wZuck/Unextended/design/interconnect-map.csv

J2_pin | Signal
1 | GND
2 | GND
3 | VCC
4 | GND
5 | ROW_DRV0
6 | ROW_DRV1
7 | ROW_DRV2
8 | ROW_DRV3
9 | ROW_DRV4
10 | GND
11 | MUX_A
12 | MUX_B
13 | MUX_C
14 | MUX0_INH
15 | MUX1_INH
16 | GND
17 | DRAIN
18 | AFE_ON_N
19 | GND
20 | ADC
21 | GND
22 | BAT_SW
23 | RESET
24 | GND
