wZuck/Unextended/design/key-map.csv

ref | row | col | u | width | label | x | y
EC1 | 0 | 0 | 0 | 1 | Esc | 9.15 | 9.2
EC2 | 0 | 1 | 1 | 1 | 1 | 28.200000000000003 | 9.2
EC3 | 0 | 2 | 2 | 1 | 2 | 47.25 | 9.2
EC4 | 0 | 3 | 3 | 1 | 3 | 66.30000000000001 | 9.2
EC5 | 0 | 4 | 4 | 1 | 4 | 85.35000000000001 | 9.2
EC6 | 0 | 5 | 5 | 1 | 5 | 104.4 | 9.2
EC7 | 0 | 6 | 6 | 1 | 6 | 123.45000000000002 | 9.2
EC8 | 0 | 7 | 7 | 1 | 7 | 142.5 | 9.2
EC9 | 0 | 8 | 8 | 1 | 8 | 161.55 | 9.2
EC10 | 0 | 9 | 9 | 1 | 9 | 180.60000000000002 | 9.2
EC11 | 0 | 10 | 10 | 1 | 0 | 199.65 | 9.2
EC12 | 0 | 11 | 11 | 1 | - | 218.70000000000002 | 9.2
EC13 | 0 | 12 | 12 | 1 | = | 237.75000000000003 | 9.2
EC14 | 0 | 14 | 13 | 2 | Backspace | 266.325 | 9.2
EC15 | 1 | 0 | 0 | 1.5 | Tab | 13.912500000000001 | 28.25
EC16 | 1 | 2 | 1.5 | 1 | Q | 37.725 | 28.25
EC17 | 1 | 3 | 2.5 | 1 | W | 56.775 | 28.25
EC18 | 1 | 4 | 3.5 | 1 | E | 75.825 | 28.25
EC19 | 1 | 5 | 4.5 | 1 | R | 94.87500000000001 | 28.25
EC20 | 1 | 6 | 5.5 | 1 | T | 113.92500000000001 | 28.25
EC21 | 1 | 7 | 6.5 | 1 | Y | 132.975 | 28.25
EC22 | 1 | 8 | 7.5 | 1 | U | 152.025 | 28.25
EC23 | 1 | 9 | 8.5 | 1 | I | 171.07500000000002 | 28.25
EC24 | 1 | 10 | 9.5 | 1 | O | 190.125 | 28.25
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
