wZuck/Unextended/design/pin-map.csv

Signal | Pro_Micro_D | nRF52840_pin | Controller_U1_pad | J2_FFC_pin
ROW_DRV0 | 0 | P0.08 | 2 | 5
ROW_DRV1 | 1 | P0.06 | 1 | 6
ROW_DRV2 | 2 | P0.17 | 5 | 7
ROW_DRV3 | 3 | P0.20 | 6 | 8
ROW_DRV4 | 4 | P0.22 | 7 | 9
MUX_A | 5 | P0.24 | 8 | 11
MUX_B | 6 | P1.00 | 9 | 12
MUX_C | 7 | P0.11 | 10 | 13
MUX0_INH | 8 | P1.04 | 11 | 14
MUX1_INH | 9 | P1.06 | 12 | 15
DRAIN | 10 | P0.09 | 13 | 17
AFE_ON_N | 15 | P1.13 | 16 | 18
ADC | 19 | P0.02/AIN0 | 18 | 20
