wZuck/Unextended/renders/website-A2.png

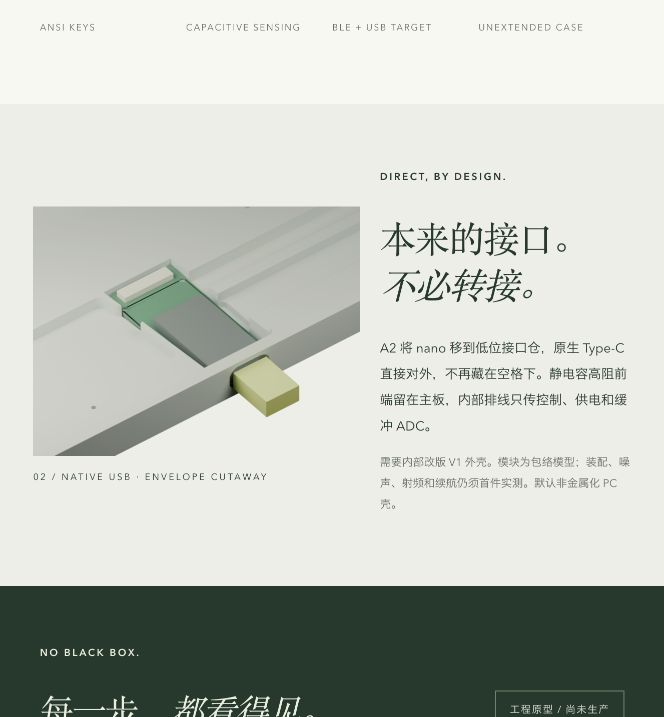
renders/website-A2.png
