wZuck/Unextended/renders/website-desktop.png

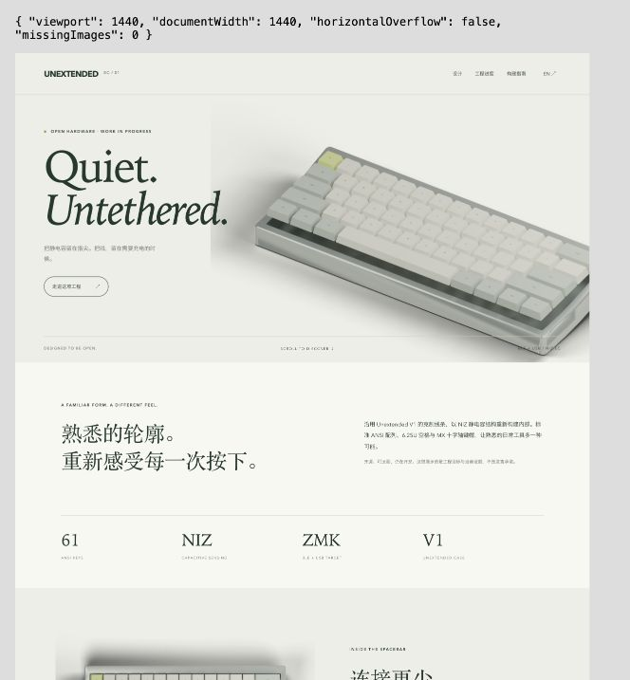
renders/website-desktop.png
