wZuck/Unextended/renders/website-mobile.png

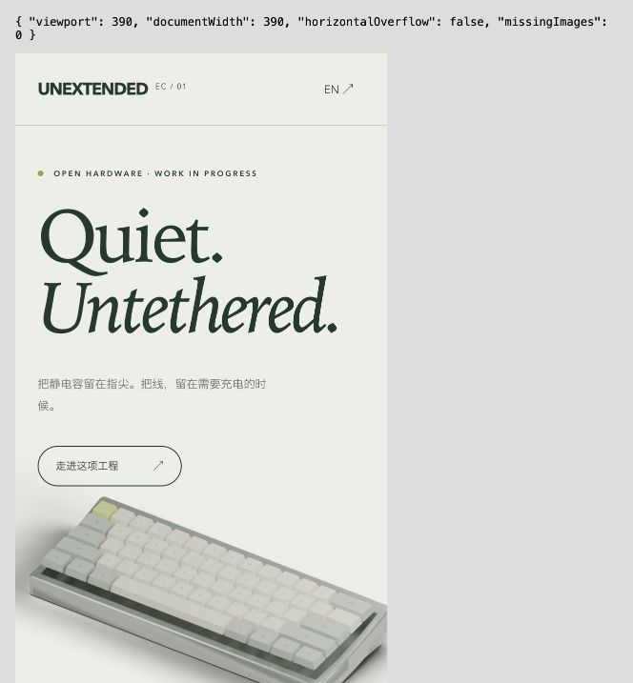
renders/website-mobile.png
