wZuck/Unextended/hardware/BOM.csv

Reference | Value | Footprint | Side | X_mm | Y_mm
J2 | FH12-24S-0.5SH | Connector_FFC-FPC:Hirose_FH12-24S-0.5SH_1x24-1MP_P0.50mm_Horizontal | B | 142.5 | 18.7
U2 | CD74HC4051M96 | Package_SO:SOIC-16_3.9x9.9mm_P1.27mm | B | 158 | 84
U3 | CD74HC4051M96 | Package_SO:SOIC-16_3.9x9.9mm_P1.27mm | B | 170 | 84
U4 | OPA350UA | Package_SO:SOIC-8_3.9x4.9mm_P1.27mm | B | 183 | 84
Q1 | AO3401A | Package_TO_SOT_SMD:SOT-23 | B | 207 | 84
R1 | 100 | Resistor_SMD:R_0805_2012Metric_Pad1.20x1.40mm_HandSolder | B | 40 | 78
R2 | 100 | Resistor_SMD:R_0805_2012Metric_Pad1.20x1.40mm_HandSolder | B | 46 | 78
R3 | 100 | Resistor_SMD:R_0805_2012Metric_Pad1.20x1.40mm_HandSolder | B | 52 | 78
R4 | 100 | Resistor_SMD:R_0805_2012Metric_Pad1.20x1.40mm_HandSolder | B | 58 | 75.8
R5 | 100 | Resistor_SMD:R_0805_2012Metric_Pad1.20x1.40mm_HandSolder | B | 64 | 78
R10 | 100k | Resistor_SMD:R_0805_2012Metric_Pad1.20x1.40mm_HandSolder | B | 119 | 78
R11 | 100k | Resistor_SMD:R_0805_2012Metric_Pad1.20x1.40mm_HandSolder | B | 126 | 78
R12 | 100k | Resistor_SMD:R_0805_2012Metric_Pad1.20x1.40mm_HandSolder | B | 133 | 78
R13 | 100k | Resistor_SMD:R_0805_2012Metric_Pad1.20x1.40mm_HandSolder | B | 140 | 78
R14 | 100k | Resistor_SMD:R_0805_2012Metric_Pad1.20x1.40mm_HandSolder | B | 147 | 78
R15 | 100k | Resistor_SMD:R_0805_2012Metric_Pad1.20x1.40mm_HandSolder | B | 125 | 75.8
R16 | 100k | Resistor_SMD:R_0805_2012Metric_Pad1.20x1.40mm_HandSolder | B | 126 | 84
R17 | 100k | Resistor_SMD:R_0805_2012Metric_Pad1.20x1.40mm_HandSolder | B | 133 | 84
R18 | 100k | Resistor_SMD:R_0805_2012Metric_Pad1.20x1.40mm_HandSolder | B | 140 | 84
R19 | 100k | Resistor_SMD:R_0805_2012Metric_Pad1.20x1.40mm_HandSolder | B | 147 | 84
R20 | 100k | Resistor_SMD:R_0805_2012Metric_Pad1.20x1.40mm_HandSolder | B | 125 | 92
R21 | 100k | Resistor_SMD:R_0805_2012Metric_Pad1.20x1.40mm_HandSolder | B | 126 | 90
R22 | 100k | Resistor_SMD:R_0805_2012Metric_Pad1.20x1.40mm_HandSolder | B | 133 | 90
R23 | 100k | Resistor_SMD:R_0805_2012Metric_Pad1.20x1.40mm_HandSolder | B | 140 | 90
R24 | 100k | Resistor_SMD:R_0805_2012Metric_Pad1.20x1.40mm_HandSolder | B | 147 | 90
R30 | 100k | Resistor_SMD:R_0805_2012Metric_Pad1.20x1.40mm_HandSolder | B | 183 | 78
R31 | 1k | Resistor_SMD:R_0805_2012Metric_Pad1.20x1.40mm_HandSolder | B | 183 | 91
R32 | 1k | Resistor_SMD:R_0805_2012Metric_Pad1.20x1.40mm_HandSolder | B | 232 | 78
R33 | 100k | Resistor_SMD:R_0805_2012Metric_Pad1.20x1.40mm_HandSolder | B | 156 | 75.5
R34 | 100k | Resistor_SMD:R_0805_2012Metric_Pad1.20x1.40mm_HandSolder | B | 164 | 78
R35 | 100k | Resistor_SMD:R_0805_2012Metric_Pad1.20x1.40mm_HandSolder | B | 200 | 78
R36 | 1k | Resistor_SMD:R_0805_2012Metric_Pad1.20x1.40mm_HandSolder | B | 207 | 78
R37 | 47 | Resistor_SMD:R_0805_2012Metric_Pad1.20x1.40mm_HandSolder | B | 187 | 78
C1 | 100n | Capacitor_SMD:C_0805_2012Metric_Pad1.18x1.45mm_HandSolder | B | 160 | 74.5
C2 | 100n | Capacitor_SMD:C_0805_2012Metric_Pad1.18x1.45mm_HandSolder | B | 164 | 91
C3 | 100n | Capacitor_SMD:C_0805_2012Metric_Pad1.18x1.45mm_HandSolder | B | 190 | 91
C4 | 220p_C0G | Capacitor_SMD:C_0805_2012Metric_Pad1.18x1.45mm_HandSolder | B | 178 | 72.5
C5 | 1u | Capacitor_SMD:C_0805_2012Metric_Pad1.18x1.45mm_HandSolder | B | 193 | 78
J1 | JST_S2B-PH-K | UnextendedEC:Battery_PH2 | B | 217 | 84
SW1 | Battery_switch_pigtail | UnextendedEC:SPST_PIGTAIL_2.54 | B | 178 | 91
SW2 | Reset_NO | UnextendedEC:RESET_2.54_TH | B | 238 | 91
EC1 | Esc | UnextendedEC:ecs_pad_1U_no_ring | F | 9.15 | 9.2
EC2 | 1 | UnextendedEC:ecs_pad_1U_no_ring | F | 28.200000000000003 | 9.2
EC3 | 2 | UnextendedEC:ecs_pad_1U_no_ring | F | 47.25 | 9.2
EC4 | 3 | UnextendedEC:ecs_pad_1U_no_ring | F | 66.30000000000001 | 9.2
EC5 | 4 | UnextendedEC:ecs_pad_1U_no_ring | F | 85.35000000000001 | 9.2
EC6 | 5 | UnextendedEC:ecs_pad_1U_no_ring | F | 104.4 | 9.2
EC7 | 6 | UnextendedEC:ecs_pad_1U_no_ring | F | 123.45000000000002 | 9.2
EC8 | 7 | UnextendedEC:ecs_pad_1U_no_ring | F | 142.5 | 9.2
EC9 | 8 | UnextendedEC:ecs_pad_1U_no_ring | F | 161.55 | 9.2
EC10 | 9 | UnextendedEC:ecs_pad_1U_no_ring | F | 180.60000000000002 | 9.2
EC11 | 0 | UnextendedEC:ecs_pad_1U_no_ring | F | 199.65 | 9.2
EC12 | - | UnextendedEC:ecs_pad_1U_no_ring | F | 218.70000000000002 | 9.2
EC13 | = | UnextendedEC:ecs_pad_1U_no_ring | F | 237.75000000000003 | 9.2
EC14 | Backspace | UnextendedEC:ecs_pad_1U_no_ring | F | 266.325 | 9.2
EC15 | Tab | UnextendedEC:ecs_pad_1U_no_ring | F | 13.912500000000001 | 28.25
EC16 | Q | UnextendedEC:ecs_pad_1U_no_ring | F | 37.725 | 28.25
EC17 | W | UnextendedEC:ecs_pad_1U_no_ring | F | 56.775 | 28.25
EC18 | E | UnextendedEC:ecs_pad_1U_no_ring | F | 75.825 | 28.25
EC19 | R | UnextendedEC:ecs_pad_1U_no_ring | F | 94.87500000000001 | 28.25
EC20 | T | UnextendedEC:ecs_pad_1U_no_ring | F | 113.92500000000001 | 28.25
EC21 | Y | UnextendedEC:ecs_pad_1U_no_ring | F | 132.975 | 28.25
EC22 | U | UnextendedEC:ecs_pad_1U_no_ring | F | 152.025 | 28.25
EC23 | I | UnextendedEC:ecs_pad_1U_no_ring | F | 171.07500000000002 | 28.25
EC24 | O | UnextendedEC:ecs_pad_1U_no_ring | F | 190.125 | 28.25
EC25 | P | UnextendedEC:ecs_pad_1U_no_ring | F | 209.175 | 28.25
EC26 | [ | UnextendedEC:ecs_pad_1U_no_ring | F | 228.22500000000002 | 28.25
EC27 | ] | UnextendedEC:ecs_pad_1U_no_ring | F | 247.275 | 28.25
EC28 | \ | UnextendedEC:ecs_pad_1U_no_ring | F | 271.0875 | 28.25
EC29 | Caps | UnextendedEC:ecs_pad_1U_no_ring | F | 16.293750000000003 | 47.3
EC30 | A | UnextendedEC:ecs_pad_1U_no_ring | F | 42.4875 | 47.3
EC31 | S | UnextendedEC:ecs_pad_1U_no_ring | F | 61.5375 | 47.3
EC32 | D | UnextendedEC:ecs_pad_1U_no_ring | F | 80.5875 | 47.3
EC33 | F | UnextendedEC:ecs_pad_1U_no_ring | F | 99.6375 | 47.3
EC34 | G | UnextendedEC:ecs_pad_1U_no_ring | F | 118.68750000000001 | 47.3
EC35 | H | UnextendedEC:ecs_pad_1U_no_ring | F | 137.7375 | 47.3
EC36 | J | UnextendedEC:ecs_pad_1U_no_ring | F | 156.78750000000002 | 47.3
EC37 | K | UnextendedEC:ecs_pad_1U_no_ring | F | 175.8375 | 47.3
EC38 | L | UnextendedEC:ecs_pad_1U_no_ring | F | 194.88750000000002 | 47.3
EC39 | ; | UnextendedEC:ecs_pad_1U_no_ring | F | 213.9375 | 47.3
EC40 | ' | UnextendedEC:ecs_pad_1U_no_ring | F | 232.9875 | 47.3
EC41 | Enter | UnextendedEC:ecs_pad_1U_no_ring | F | 263.94375 | 47.3
EC42 | Shift | UnextendedEC:ecs_pad_1U_no_ring | F | 21.05625 | 66.35000000000001
EC43 | Z | UnextendedEC:ecs_pad_1U_no_ring | F | 52.0125 | 66.35000000000001
EC44 | X | UnextendedEC:ecs_pad_1U_no_ring | F | 71.0625 | 66.35000000000001
EC45 | C | UnextendedEC:ecs_pad_1U_no_ring | F | 90.11250000000001 | 66.35000000000001
EC46 | V | UnextendedEC:ecs_pad_1U_no_ring | F | 109.16250000000001 | 66.35000000000001
EC47 | B | UnextendedEC:ecs_pad_1U_no_ring | F | 128.2125 | 66.35000000000001
EC48 | N | UnextendedEC:ecs_pad_1U_no_ring | F | 147.26250000000002 | 66.35000000000001
EC49 | M | UnextendedEC:ecs_pad_1U_no_ring | F | 166.3125 | 66.35000000000001
EC50 | , | UnextendedEC:ecs_pad_1U_no_ring | F | 185.3625 | 66.35000000000001
EC51 | . | UnextendedEC:ecs_pad_1U_no_ring | F | 204.41250000000002 | 66.35000000000001
EC52 | / | UnextendedEC:ecs_pad_1U_no_ring | F | 223.4625 | 66.35000000000001
EC53 | RShift | UnextendedEC:ecs_pad_1U_no_ring | F | 259.18125 | 66.35000000000001
EC54 | LCTRL | UnextendedEC:ecs_pad_1U_no_ring | F | 11.53125 | 85.4
EC55 | LGUI | UnextendedEC:ecs_pad_1U_no_ring | F | 35.34375 | 85.4
EC56 | LAlt | UnextendedEC:ecs_pad_1U_no_ring | F | 59.15625 | 85.4
EC57 | Space | UnextendedEC:ecs_pad_1U_no_ring | F | 130.59375 | 85.4
EC58 | RAlt | UnextendedEC:ecs_pad_1U_no_ring | F | 202.03125 | 85.4
EC59 | Fn | UnextendedEC:ecs_pad_1U_no_ring | F | 225.84375 | 85.4
EC60 | Menu | UnextendedEC:ecs_pad_1U_no_ring | F | 249.65625000000003 | 85.4
EC61 | RCTRL | UnextendedEC:ecs_pad_1U_no_ring | F | 273.46875 | 85.4
