wZuck/Unextended/mechanical/direct-usb-assembly.step

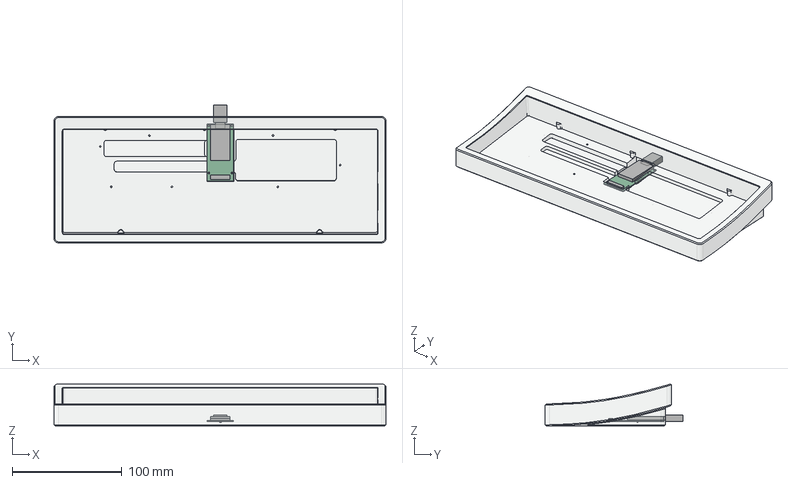
[picture p7: CAD file, 2026-10-23]
mechanical/direct-usb-assembly.step
302.3 x 125.4 x 38.1 mm
modified_PC_V1_case
carrier
module_envelope
ffc_connector
adc_capacitor
external_plug_envelope
