wZuck/Unextended/mechanical/reference/Unextended_V1_220331.step

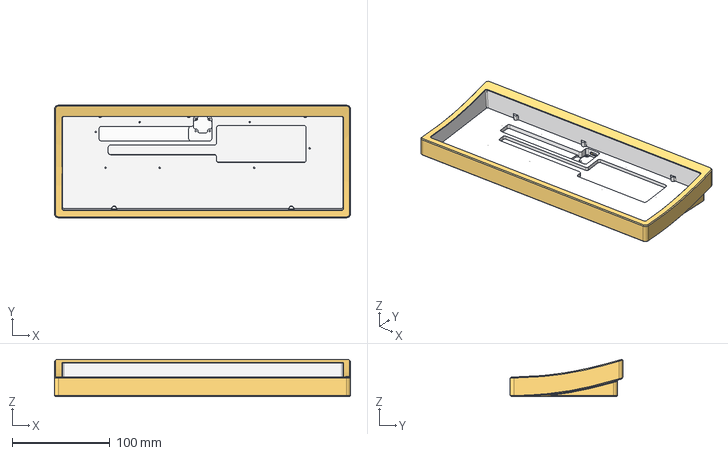
[picture p8: CAD file, 2026-10-23]
mechanical/reference/Unextended_V1_220331.step
302.3 x 115.0 x 38.1 mm
