wZuck/Unextended/mechanical/render/EC61.stl

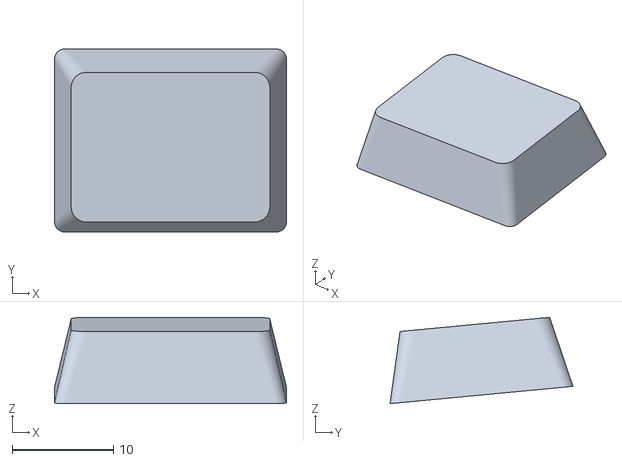
[picture p9: CAD file, 2026-10-23]
mechanical/render/EC61.stl
22.9 x 18.1 x 8.52
