wZuck/Unextended/mechanical/usb-render/external_plug_envelope.stl

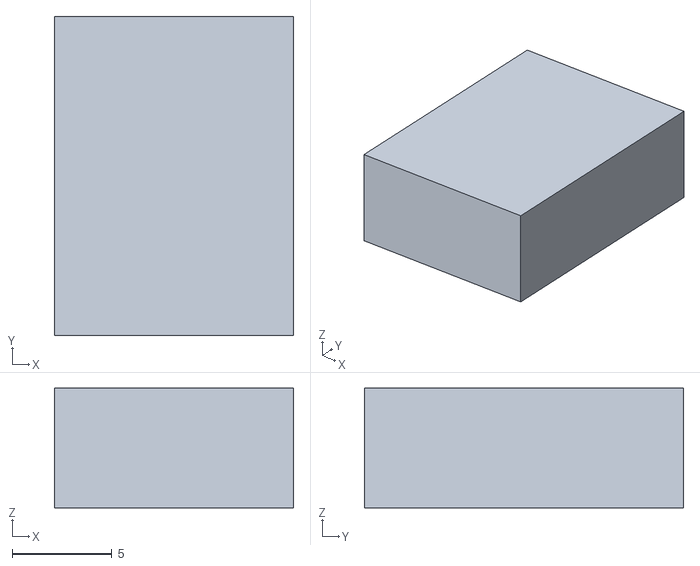
[picture p10: CAD file, 2026-10-23]
mechanical/usb-render/external_plug_envelope.stl
12.0 x 16.0 x 6.00
