wZuck/Unextended/mechanical/usb-render/adc_capacitor.stl

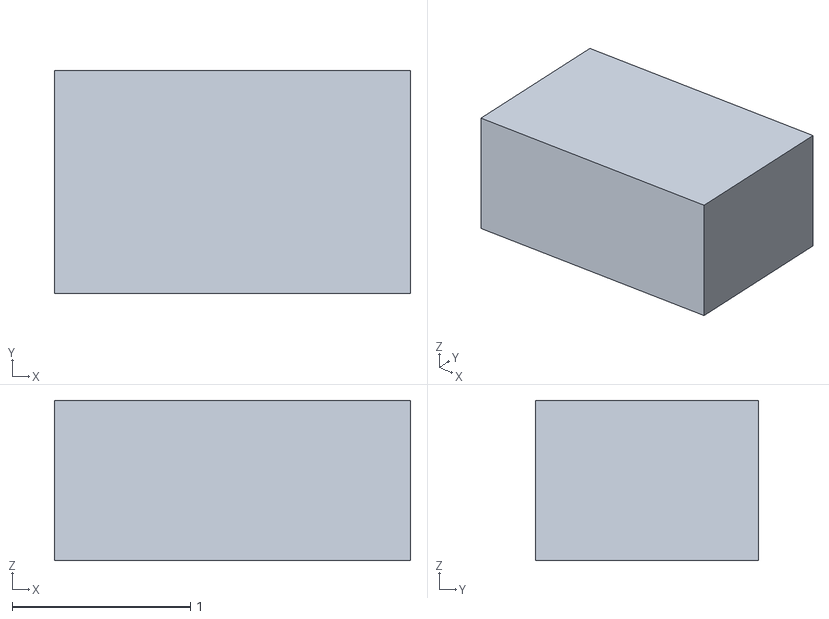
[picture p11: CAD file, 2026-10-23]
mechanical/usb-render/adc_capacitor.stl
2.00 x 1.25 x 0.9
