wZuck/Unextended/mechanical/render/EC49.stl

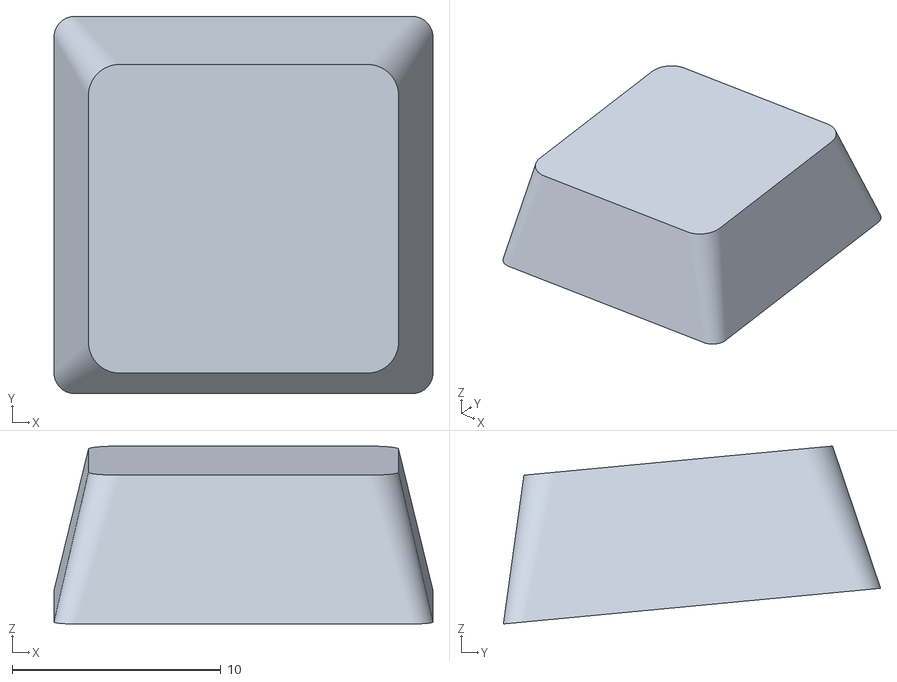
[picture p12: CAD file, 2026-10-23]
mechanical/render/EC49.stl
18.2 x 18.1 x 8.52
