wZuck/Unextended/mechanical/usb-carrier-envelope.step

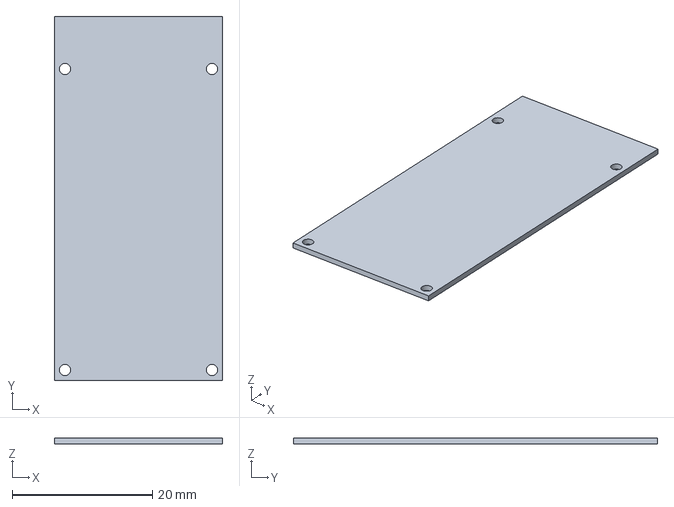
[picture p13: CAD file, 2026-10-23]
mechanical/usb-carrier-envelope.step
24.0 x 52.0 x 0.8 mm
