wZuck/Unextended/mechanical/usb-render/ffc_connector.stl

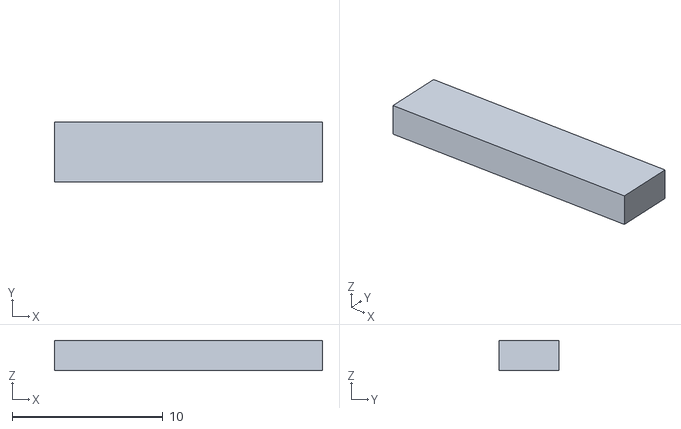
[picture p14: CAD file, 2026-10-23]
mechanical/usb-render/ffc_connector.stl
17.8 x 4.00 x 2.00
