wZuck/Unextended/mechanical/niz-fit-coupon.step

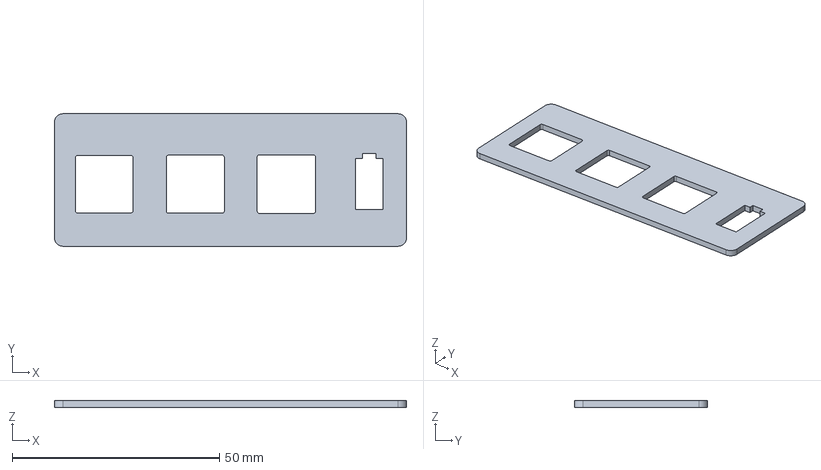
[picture p15: CAD file, 2026-10-23]
mechanical/niz-fit-coupon.step
85.0 x 32.0 x 1.60 mm
