wZuck/Unextended/mechanical/render/EC42.stl

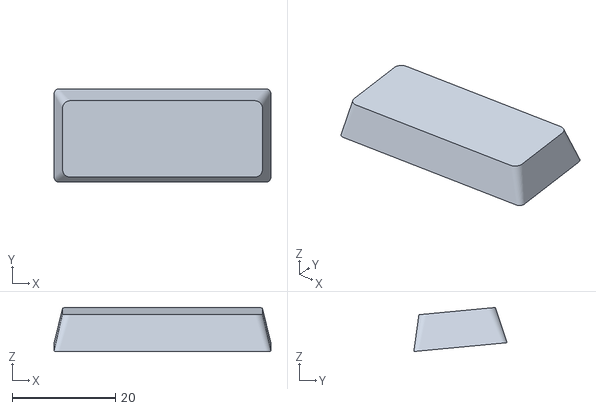
[picture p16: CAD file, 2026-10-23]
mechanical/render/EC42.stl
42.0 x 18.1 x 8.52
