wZuck/Unextended/mechanical/niz-ansi-plate.step

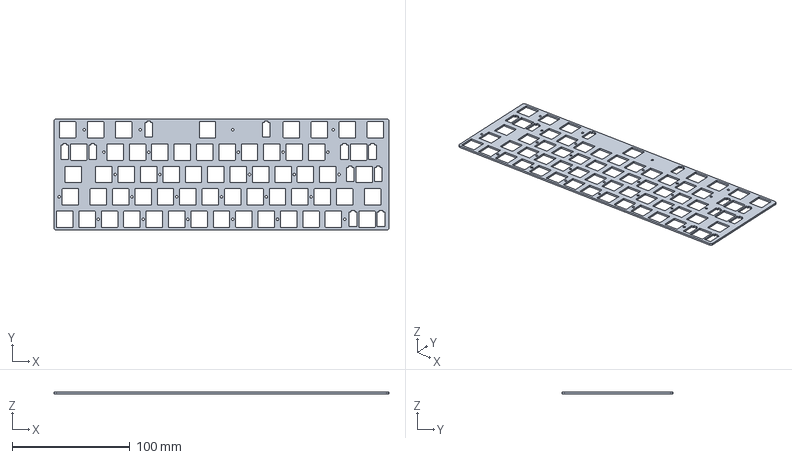
[picture p17: CAD file, 2026-10-23]
mechanical/niz-ansi-plate.step
285.0 x 94.6 x 1.60 mm
