wZuck/Unextended/mechanical/usb-render/case-cutaway.stl

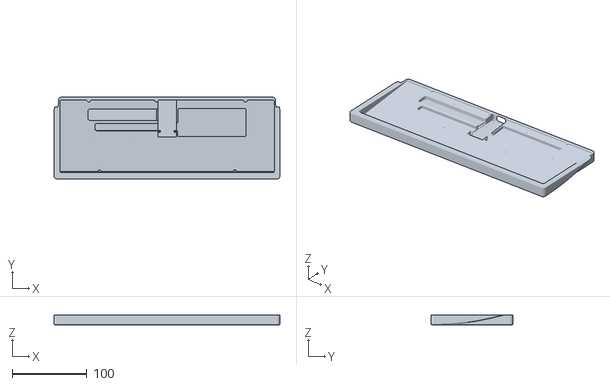
[picture p18: CAD file, 2026-10-23]
mechanical/usb-render/case-cutaway.stl
302.3 x 109.4 x 13.0
