wZuck/Unextended/mechanical/usb-render/module_envelope.stl

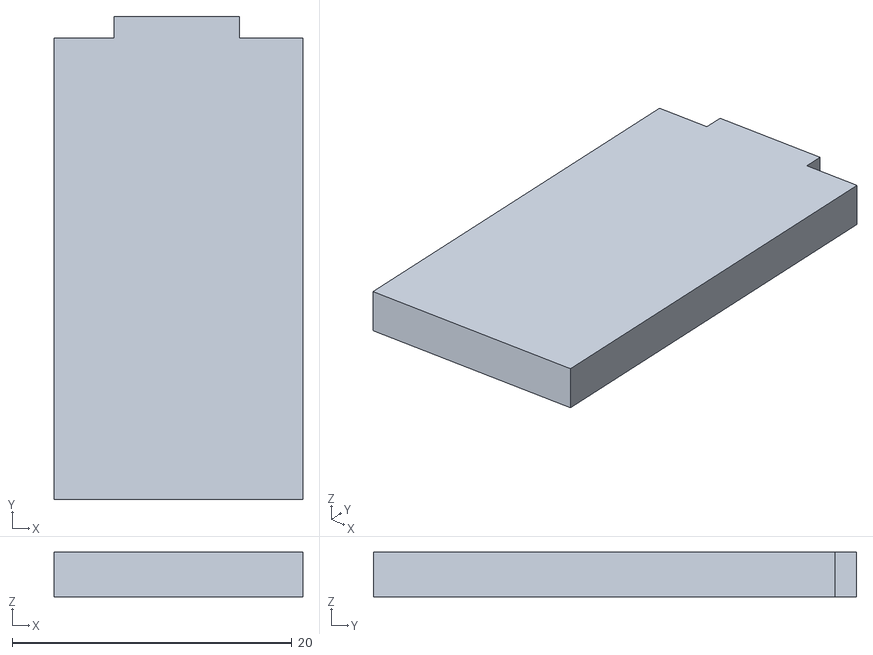
[picture p19: CAD file, 2026-10-23]
mechanical/usb-render/module_envelope.stl
17.8 x 34.5 x 3.20
