wZuck/Unextended/mechanical/render/EC28.stl

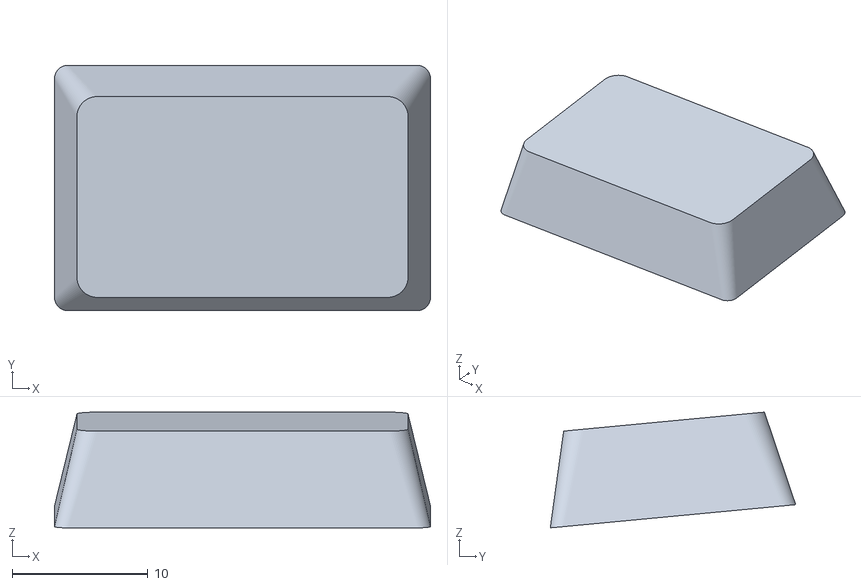
[picture p20: CAD file, 2026-10-23]
mechanical/render/EC28.stl
27.7 x 18.1 x 8.52
