wZuck/Unextended/mechanical/render/EC14.stl

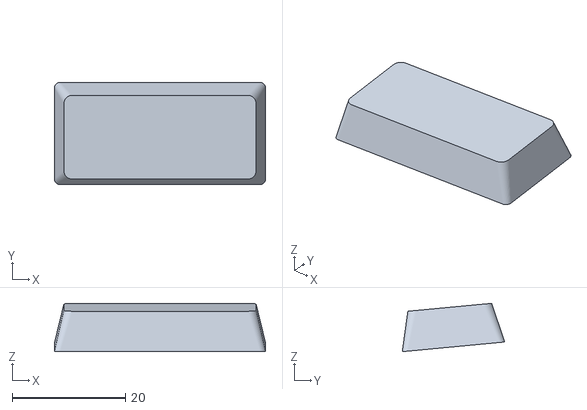
[picture p21: CAD file, 2026-10-23]
mechanical/render/EC14.stl
37.2 x 18.1 x 8.52
