wZuck/Unextended/mechanical/render/EC53.stl

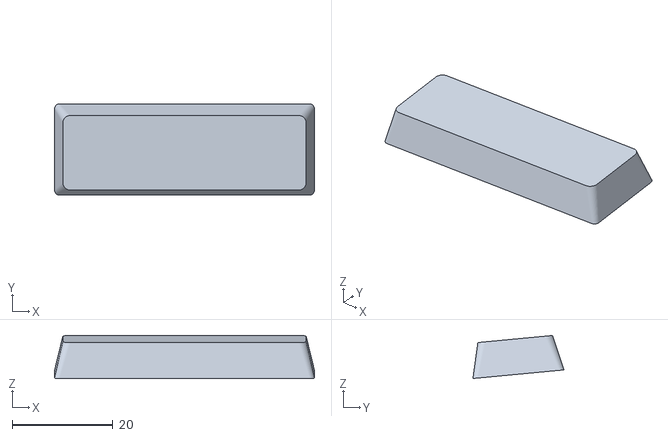
[picture p22: CAD file, 2026-10-23]
mechanical/render/EC53.stl
51.5 x 18.1 x 8.52
