wZuck/Unextended/mechanical/render/EC57.stl

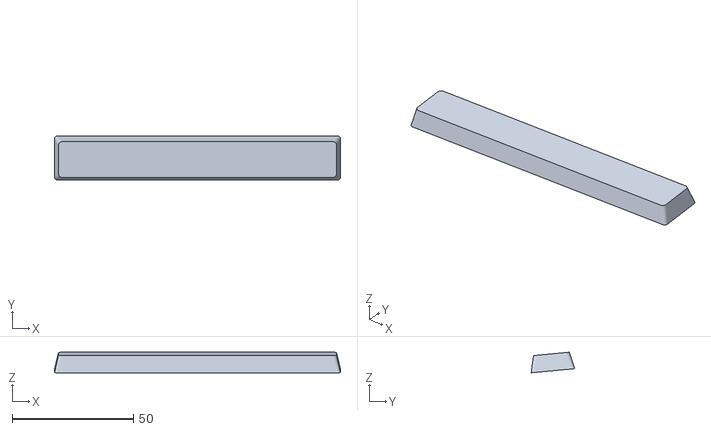
[picture p23: CAD file, 2026-10-23]
mechanical/render/EC57.stl
118.2 x 18.1 x 8.52
