wZuck/Unextended/mechanical/render/EC29.stl

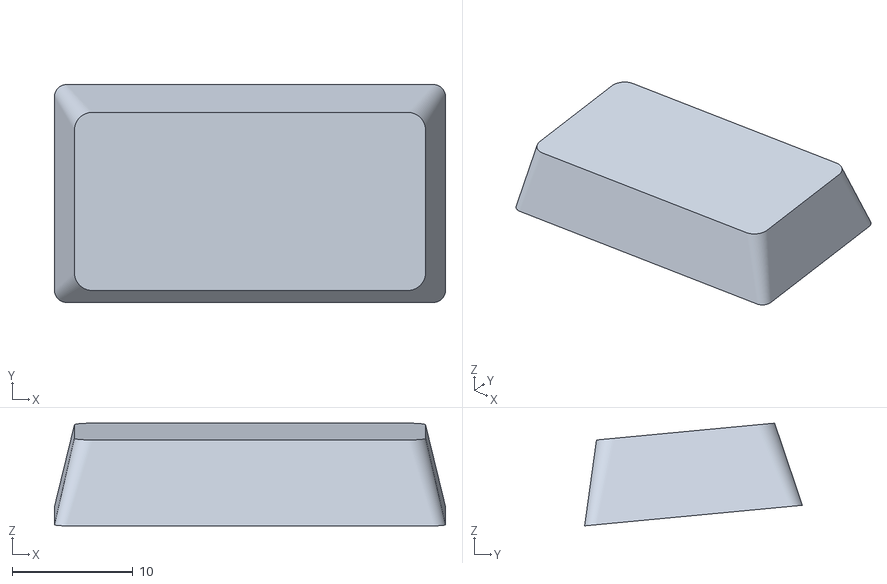
[picture p24: CAD file, 2026-10-23]
mechanical/render/EC29.stl
32.4 x 18.1 x 8.52
