wZuck/Unextended/(list of files, cad)

Other CAD files:
mechanical/Unextended_V1_EC_direct_USB.step
mechanical/render/EC54.stl
mechanical/usb-render/carrier.stl
mechanical/render/EC25.stl
mechanical/render/EC35.stl
mechanical/render/EC51.stl
mechanical/render/EC11.stl
mechanical/render/EC30.stl
mechanical/render/EC17.stl
mechanical/render/EC2.stl
mechanical/render/EC31.stl
mechanical/render/EC50.stl
mechanical/render/EC27.stl
mechanical/render/EC6.stl
mechanical/render/EC45.stl
mechanical/render/EC60.stl
mechanical/render/EC21.stl
mechanical/render/EC12.stl
mechanical/render/EC48.stl
mechanical/render/EC20.stl
mechanical/render/EC15.stl
mechanical/render/EC13.stl
mechanical/render/EC18.stl
mechanical/render/EC39.stl
mechanical/render/EC16.stl
mechanical/render/EC59.stl
mechanical/render/EC37.stl
mechanical/render/EC4.stl
mechanical/render/EC9.stl
mechanical/render/EC52.stl
mechanical/render/EC5.stl
mechanical/render/case.stl
mechanical/render/EC22.stl
mechanical/render/EC32.stl
mechanical/render/EC41.stl
mechanical/render/EC34.stl
mechanical/render/EC56.stl
mechanical/render/EC33.stl
mechanical/render/EC1.stl
mechanical/render/EC38.stl
mechanical/render/EC40.stl
mechanical/render/EC44.stl
mechanical/render/EC10.stl
mechanical/render/EC47.stl
mechanical/render/EC36.stl
mechanical/render/EC43.stl
mechanical/render/EC55.stl
mechanical/render/EC8.stl
mechanical/render/EC24.stl
mechanical/render/EC58.stl
mechanical/render/EC3.stl
mechanical/render/EC7.stl
mechanical/render/EC26.stl
mechanical/render/EC46.stl
mechanical/render/EC23.stl
mechanical/render/EC19.stl
mechanical/niz-ansi-plate.dxf
mechanical/niz-fit-coupon.dxf
renders/direct-usb-cutaway.blend
renders/unextended-concept.blend
