wZuck/Unextended/hardware/UnextendedEC-controller-schematic.pdf

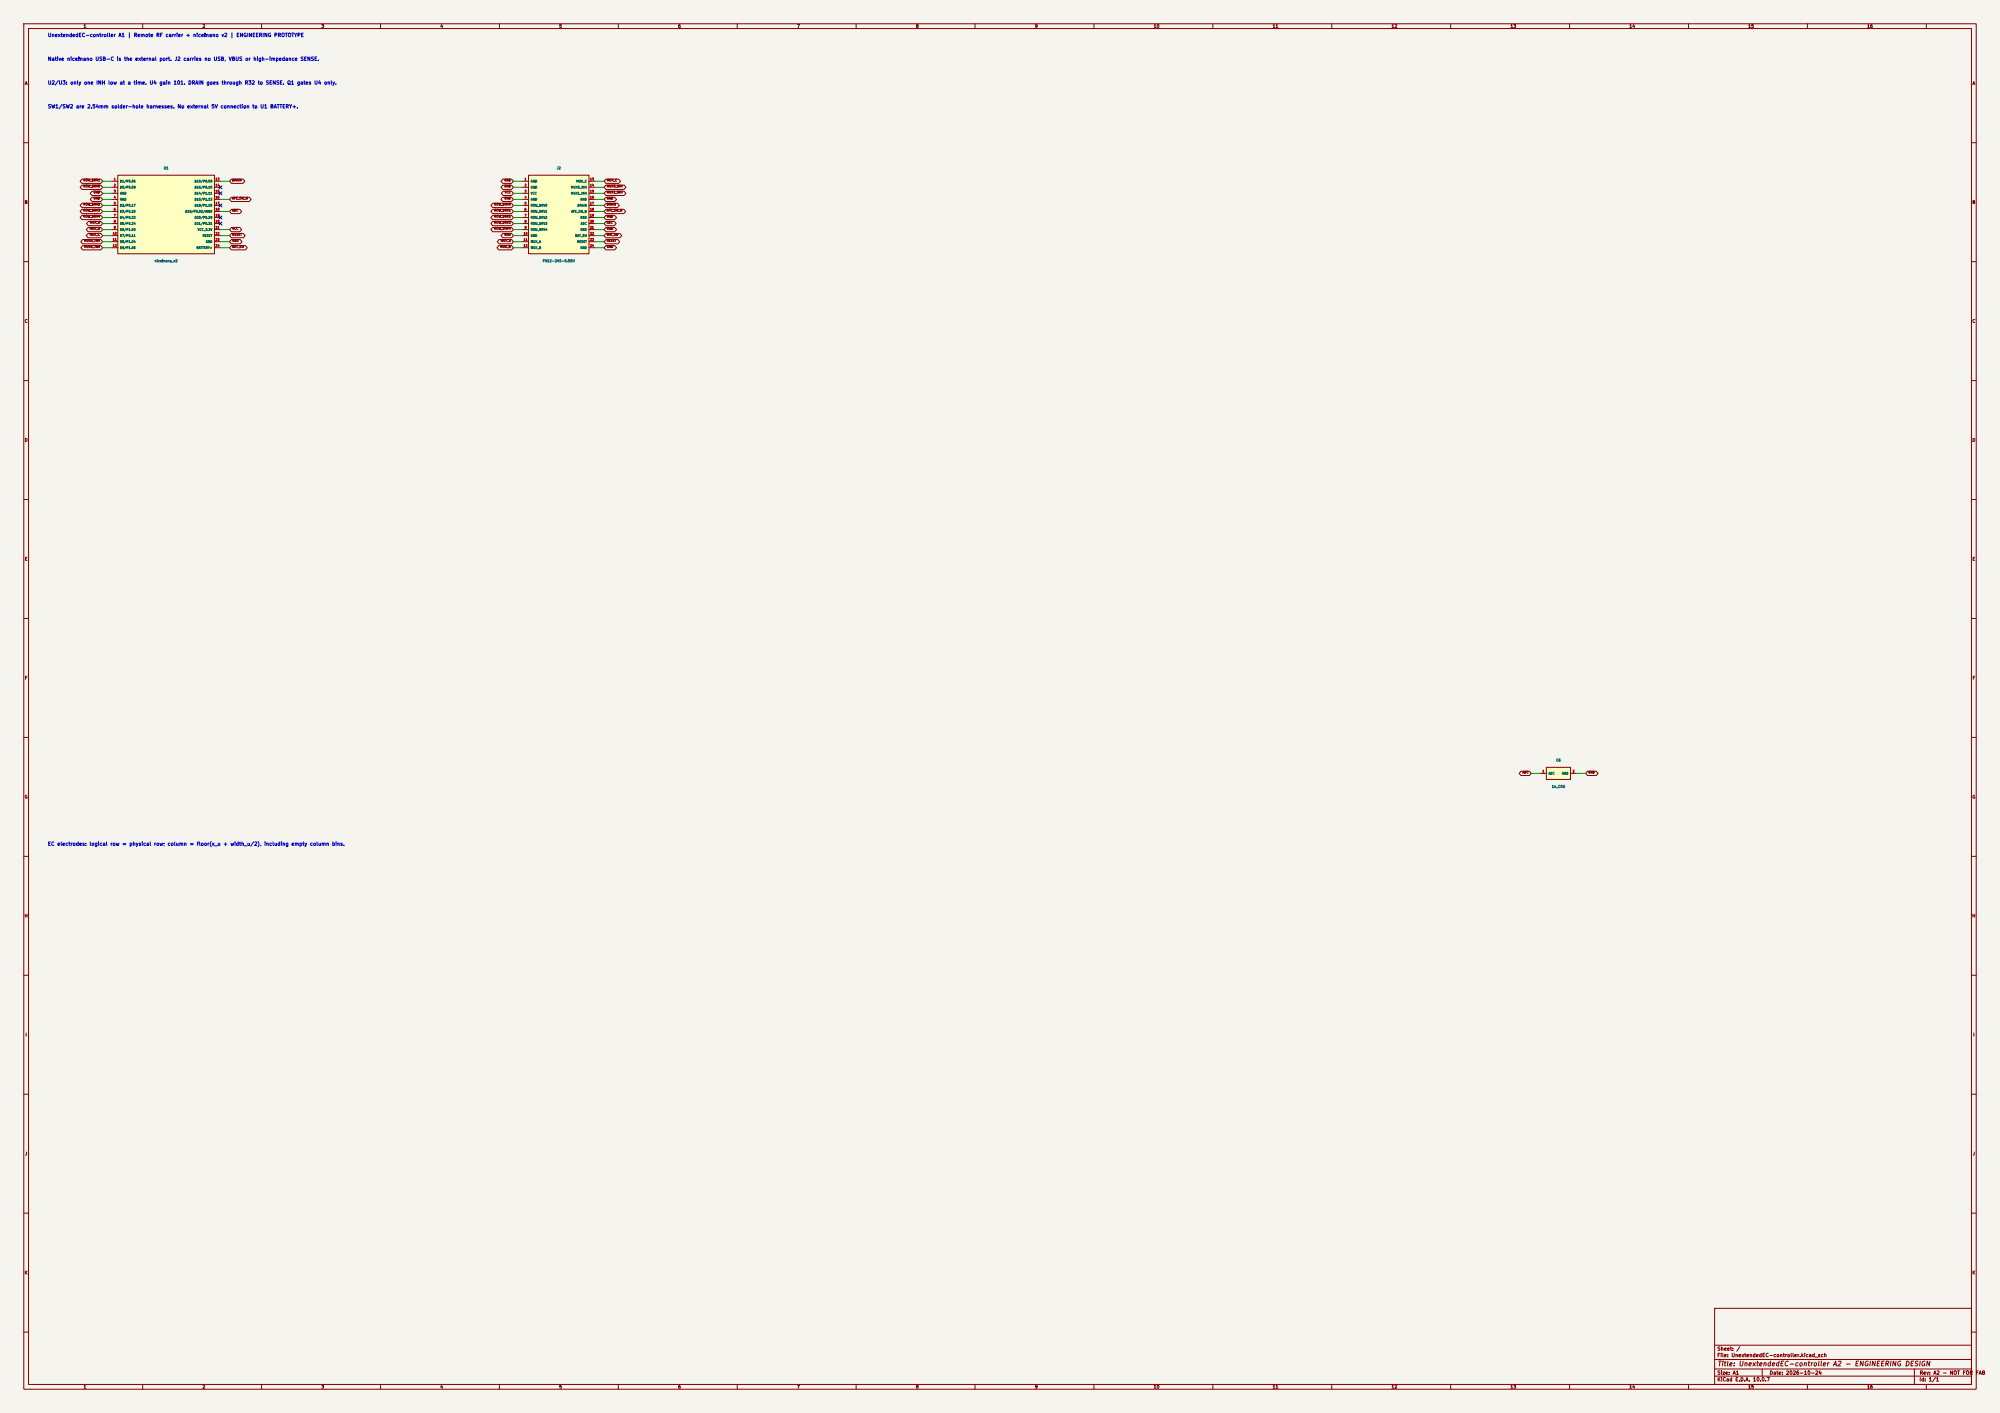
[picture p25: page 1]

ROW_DRV1 ROW_DRV0 UnextendedEC-controller A1 | Remote RF carrier + nice!nano v2 | ENGINEERING PROTOTYPE

Native nice!nano USB-C is the external port. J2 carries no USB, VBUS or high-impedance SENSE.

U2/U3: only one INH low at a time. U4 gain 101. DRAIN goes through R32 to SENSE. Q1 gates U4 only.

SW1/SW2 are 2.54mm solder-hole harnesses. No external 5V connection to U1 BATTERY+.

EC electrodes: logical row = physical row; column = floor(x_u + width_u/2), including empty column bins.

Sheet: /
File: UnextendedEC-controller.kicad_sch
Title: UnextendedEC-controller A2 - ENGINEERING DESIGN
