wZuck/Unextended/(list of files, drawings)

Other design files:
hardware/UnextendedEC-controller.dsn
hardware/UnextendedEC.dsn
