wZuck/Unextended/hardware/UnextendedEC.kicad_pcb

## KiCad design hardware/UnextendedEC.kicad_pcb (2026-10-23)

Schematic: UnextendedEC.kicad_sch, UnextendedEC A2 - ENGINEERING DESIGN

Parts:
C1, C2, C3: 100n; C_0805_2012Metric_Pad1.18x1.45mm_HandSolder
C4: 220p_C0G; C_0805_2012Metric_Pad1.18x1.45mm_HandSolder
C5: 1u; C_0805_2012Metric_Pad1.18x1.45mm_HandSolder
EC1: Esc; ecs_pad_1U_no_ring
EC2: 1; ecs_pad_1U_no_ring
EC3: 2; ecs_pad_1U_no_ring
EC4: 3; ecs_pad_1U_no_ring
EC5: 4; ecs_pad_1U_no_ring
EC6: 5; ecs_pad_1U_no_ring
EC7: 6; ecs_pad_1U_no_ring
EC8: 7; ecs_pad_1U_no_ring
EC9: 8; ecs_pad_1U_no_ring
EC10: 9; ecs_pad_1U_no_ring
EC11: 0; ecs_pad_1U_no_ring
EC12: -; ecs_pad_1U_no_ring
EC13: =; ecs_pad_1U_no_ring
EC14: Backspace; ecs_pad_1U_no_ring
EC15: Tab; ecs_pad_1U_no_ring
EC16: Q; ecs_pad_1U_no_ring
EC17: W; ecs_pad_1U_no_ring
EC18: E; ecs_pad_1U_no_ring
EC19: R; ecs_pad_1U_no_ring
EC20: T; ecs_pad_1U_no_ring
EC21: Y; ecs_pad_1U_no_ring
EC22: U; ecs_pad_1U_no_ring
EC23: I; ecs_pad_1U_no_ring
EC24: O; ecs_pad_1U_no_ring
EC25: P; ecs_pad_1U_no_ring
EC26: [; ecs_pad_1U_no_ring
EC27: ]; ecs_pad_1U_no_ring
EC28: \; ecs_pad_1U_no_ring
EC29: Caps; ecs_pad_1U_no_ring
EC30: A; ecs_pad_1U_no_ring
EC31: S; ecs_pad_1U_no_ring
EC32: D; ecs_pad_1U_no_ring
EC33: F; ecs_pad_1U_no_ring
EC34: G; ecs_pad_1U_no_ring
EC35: H; ecs_pad_1U_no_ring
EC36: J; ecs_pad_1U_no_ring
EC37: K; ecs_pad_1U_no_ring
EC38: L; ecs_pad_1U_no_ring
EC39: ;; ecs_pad_1U_no_ring
EC40: '; ecs_pad_1U_no_ring
EC41: Enter; ecs_pad_1U_no_ring
EC42: Shift; ecs_pad_1U_no_ring
EC43: Z; ecs_pad_1U_no_ring
EC44: X; ecs_pad_1U_no_ring
EC45: C; ecs_pad_1U_no_ring
EC46: V; ecs_pad_1U_no_ring
EC47: B; ecs_pad_1U_no_ring
EC48: N; ecs_pad_1U_no_ring
EC49: M; ecs_pad_1U_no_ring
EC50: ,; ecs_pad_1U_no_ring
EC51: .; ecs_pad_1U_no_ring
EC52: /; ecs_pad_1U_no_ring
EC53: RShift; ecs_pad_1U_no_ring
EC54: LCTRL; ecs_pad_1U_no_ring
EC55: LGUI; ecs_pad_1U_no_ring
EC56: LAlt; ecs_pad_1U_no_ring
EC57: Space; ecs_pad_1U_no_ring
EC58: RAlt; ecs_pad_1U_no_ring
EC59: Fn; ecs_pad_1U_no_ring
EC60: Menu; ecs_pad_1U_no_ring
EC61: RCTRL; ecs_pad_1U_no_ring
J1: JST_S2B-PH-K; Battery_PH2
J2: FH12-24S-0.5SH; Hirose_FH12-24S-0.5SH_1x24-1MP_P0.50mm_Horizontal
Q1: AO3401A; SOT-23
R1, R2, R3, R4, R5: 100; R_0805_2012Metric_Pad1.20x1.40mm_HandSolder
R10, R11, R12, R13, R14, R15, R16, R17, R18, R19, R20, R21, R22, R23, R24, R30, R33, R34, R35: 100k; R_0805_2012Metric_Pad1.20x1.40mm_HandSolder
R31, R32, R36: 1k; R_0805_2012Metric_Pad1.20x1.40mm_HandSolder
R37: 47; R_0805_2012Metric_Pad1.20x1.40mm_HandSolder
SW1: Battery_switch_pigtail; SPST_PIGTAIL_2.54
SW2: Reset_NO; RESET_2.54_TH
U2, U3: CD74HC4051M96; SOIC-16_3.9x9.9mm_P1.27mm
U4: OPA350UA; SOIC-8_3.9x4.9mm_P1.27mm

Connections:
ADC: J2.20 (ADC), R37.2 (ADC)
AFE_3V3: C3.1 (AFE_3V3), Q1.3 (D), U4.7 (V+)
AFE_GATE: Q1.1 (G), R35.1 (AFE_GATE), R36.2 (AFE_GATE)
AFE_ON_N: J2.18 (AFE_ON_N), R36.1 (AFE_ON_N)
AMP_OUT: R30.1 (AMP_OUT), R37.1 (AMP_OUT), U4.6 (OUT)
BAT_RAW: J1.1 (BAT_RAW), SW1.1 (BAT_RAW)
BAT_SW: J2.22 (BAT_SW), SW1.2 (BAT_SW)
COL0: EC1.2 (SENSE), EC15.2 (SENSE), EC29.2 (SENSE), EC54.2 (SENSE), R10.1 (COL0), U2.13 (X0)
COL1: EC2.2 (SENSE), EC42.2 (SENSE), EC55.2 (SENSE), R11.1 (COL1), U2.14 (X1)
COL2: EC3.2 (SENSE), EC16.2 (SENSE), EC30.2 (SENSE), EC43.2 (SENSE), R12.1 (COL2), U2.15 (X2)
COL3: EC4.2 (SENSE), EC17.2 (SENSE), EC31.2 (SENSE), EC44.2 (SENSE), EC56.2 (SENSE), R13.1 (COL3), U2.12 (X3)
COL4: EC5.2 (SENSE), EC18.2 (SENSE), EC32.2 (SENSE), EC45.2 (SENSE), R14.1 (COL4), U2.1 (X4)
COL5: EC6.2 (SENSE), EC19.2 (SENSE), EC33.2 (SENSE), EC46.2 (SENSE), R15.1 (COL5), U2.5 (X5)
COL6: EC7.2 (SENSE), EC20.2 (SENSE), EC34.2 (SENSE), EC47.2 (SENSE), EC57.2 (SENSE), R16.1 (COL6), U2.2 (X6)
COL7: EC8.2 (SENSE), EC21.2 (SENSE), EC35.2 (SENSE), EC48.2 (SENSE), R17.1 (COL7), U2.4 (X7)
COL8: EC9.2 (SENSE), EC22.2 (SENSE), EC36.2 (SENSE), EC49.2 (SENSE), R18.1 (COL8), U3.13 (X0)
COL9: EC10.2 (SENSE), EC23.2 (SENSE), EC37.2 (SENSE), EC50.2 (SENSE), R19.1 (COL9), U3.14 (X1)
COL10: EC11.2 (SENSE), EC24.2 (SENSE), EC38.2 (SENSE), EC51.2 (SENSE), EC58.2 (SENSE), R20.1 (COL10), U3.15 (X2)
COL11: EC12.2 (SENSE), EC25.2 (SENSE), EC39.2 (SENSE), EC52.2 (SENSE), EC59.2 (SENSE), R21.1 (COL11), U3.12 (X3)
COL12: EC13.2 (SENSE), EC26.2 (SENSE), EC40.2 (SENSE), R22.1 (COL12), U3.1 (X4)
COL13: EC27.2 (SENSE), EC41.2 (SENSE), EC53.2 (SENSE), EC60.2 (SENSE), R23.1 (COL13), U3.5 (X5)
COL14: EC14.2 (SENSE), EC28.2 (SENSE), EC61.2 (SENSE), R24.1 (COL14), U3.2 (X6)
DRAIN: J2.17 (DRAIN), R32.1 (DRAIN)
FB: R30.2 (FB), R31.1 (FB), U4.2 (IN-)
GND: C1.2 (GND), C2.2 (GND), C3.2 (GND), C4.2 (GND), C5.2 (GND), EC1.3 (GUARD), EC2.3 (GUARD), EC3.3 (GUARD), EC4.3 (GUARD), EC5.3 (GUARD), EC6.3 (GUARD), EC7.3 (GUARD), EC8.3 (GUARD), EC9.3 (GUARD), EC10.3 (GUARD), EC11.3 (GUARD), EC12.3 (GUARD), EC13.3 (GUARD), EC14.3 (GUARD), EC15.3 (GUARD), EC16.3 (GUARD), EC17.3 (GUARD), EC18.3 (GUARD), EC19.3 (GUARD), EC20.3 (GUARD), EC21.3 (GUARD), EC22.3 (GUARD), EC23.3 (GUARD), EC24.3 (GUARD), EC25.3 (GUARD), EC26.3 (GUARD), EC27.3 (GUARD), EC28.3 (GUARD), EC29.3 (GUARD), EC30.3 (GUARD), EC31.3 (GUARD), EC32.3 (GUARD), EC33.3 (GUARD), EC34.3 (GUARD), EC35.3 (GUARD), EC36.3 (GUARD), EC37.3 (GUARD), EC38.3 (GUARD), EC39.3 (GUARD), EC40.3 (GUARD), EC41.3 (GUARD), EC42.3 (GUARD), EC43.3 (GUARD), EC44.3 (GUARD), EC45.3 (GUARD), EC46.3 (GUARD), EC47.3 (GUARD), EC48.3 (GUARD), EC49.3 (GUARD), EC50.3 (GUARD), EC51.3 (GUARD), EC52.3 (GUARD), EC53.3 (GUARD), EC54.3 (GUARD), EC55.3 (GUARD), EC56.3 (GUARD), EC57.3 (GUARD), EC58.3 (GUARD), EC59.3 (GUARD), EC60.3 (GUARD), EC61.3 (GUARD), J1.2 (GND), J2.1 (GND), J2.2 (GND), J2.4 (GND), J2.10 (GND), J2.16 (GND), J2.19 (GND), J2.21 (GND), J2.24 (GND), R10.2 (GND), R11.2 (GND), R12.2 (GND), R13.2 (GND), R14.2 (GND), R15.2 (GND), R16.2 (GND), R17.2 (GND), R18.2 (GND), R19.2 (GND), R20.2 (GND), R21.2 (GND), R22.2 (GND), R23.2 (GND), R24.2 (GND), R31.2 (GND), SW2.2 (GND), U2.7 (VEE), U2.8 (GND), U3.4 (X7), U3.7 (VEE), U3.8 (GND), U4.4 (V-)
MUX0_INH: J2.14 (MUX0_INH), R33.1 (MUX0_INH), U2.6 (INH)
MUX1_INH: J2.15 (MUX1_INH), R34.1 (MUX1_INH), U3.6 (INH)
MUX_A: J2.11 (MUX_A), U2.11 (A), U3.11 (A)
MUX_B: J2.12 (MUX_B), U2.10 (B), U3.10 (B)
MUX_C: J2.13 (MUX_C), U2.9 (C), U3.9 (C)
RESET: J2.23 (RESET), SW2.1 (RESET)
ROW0: EC1.1 (DRIVE), EC2.1 (DRIVE), EC3.1 (DRIVE), EC4.1 (DRIVE), EC5.1 (DRIVE), EC6.1 (DRIVE), EC7.1 (DRIVE), EC8.1 (DRIVE), EC9.1 (DRIVE), EC10.1 (DRIVE), EC11.1 (DRIVE), EC12.1 (DRIVE), EC13.1 (DRIVE), EC14.1 (DRIVE), R1.2 (ROW0)
ROW1: EC15.1 (DRIVE), EC16.1 (DRIVE), EC17.1 (DRIVE), EC18.1 (DRIVE), EC19.1 (DRIVE), EC20.1 (DRIVE), EC21.1 (DRIVE), EC22.1 (DRIVE), EC23.1 (DRIVE), EC24.1 (DRIVE), EC25.1 (DRIVE), EC26.1 (DRIVE), EC27.1 (DRIVE), EC28.1 (DRIVE), R2.2 (ROW1)
ROW2: EC29.1 (DRIVE), EC30.1 (DRIVE), EC31.1 (DRIVE), EC32.1 (DRIVE), EC33.1 (DRIVE), EC34.1 (DRIVE), EC35.1 (DRIVE), EC36.1 (DRIVE), EC37.1 (DRIVE), EC38.1 (DRIVE), EC39.1 (DRIVE), EC40.1 (DRIVE), EC41.1 (DRIVE), R3.2 (ROW2)
ROW3: EC42.1 (DRIVE), EC43.1 (DRIVE), EC44.1 (DRIVE), EC45.1 (DRIVE), EC46.1 (DRIVE), EC47.1 (DRIVE), EC48.1 (DRIVE), EC49.1 (DRIVE), EC50.1 (DRIVE), EC51.1 (DRIVE), EC52.1 (DRIVE), EC53.1 (DRIVE), R4.2 (ROW3)
ROW4: EC54.1 (DRIVE), EC55.1 (DRIVE), EC56.1 (DRIVE), EC57.1 (DRIVE), EC58.1 (DRIVE), EC59.1 (DRIVE), EC60.1 (DRIVE), EC61.1 (DRIVE), R5.2 (ROW4)
ROW_DRV0: J2.5 (ROW_DRV0), R1.1 (ROW_DRV0)
ROW_DRV1: J2.6 (ROW_DRV1), R2.1 (ROW_DRV1)
ROW_DRV2: J2.7 (ROW_DRV2), R3.1 (ROW_DRV2)
ROW_DRV3: J2.8 (ROW_DRV3), R4.1 (ROW_DRV3)
ROW_DRV4: J2.9 (ROW_DRV4), R5.1 (ROW_DRV4)
SENSE: C4.1 (SENSE), R32.2 (SENSE), U2.3 (COM), U3.3 (COM), U4.3 (IN+)
VCC: C1.1 (VCC), C2.1 (VCC), C5.1 (VCC), J2.3 (VCC), Q1.2 (S), R33.2 (VCC), R34.2 (VCC), R35.2 (VCC), U2.16 (VCC), U3.16 (VCC)

Notes on the sheet:
UnextendedEC A2 | NiZ EC + ANSI 6.25u + nice!nano v2 | ENGINEERING PROTOTYPE
Native nice!nano USB-C is the external port. J2 carries no USB, VBUS or high-impedance SENSE.
U2/U3: only one INH low at a time. U4 gain 101. DRAIN goes through R32 to SENSE. Q1 gates U4 only.
SW1/SW2 are 2.54mm solder-hole harnesses. No external 5V connection to U1 BATTERY+.
EC electrodes: logical row = physical row; column = floor(x_u + width_u/2), including empty column bins.

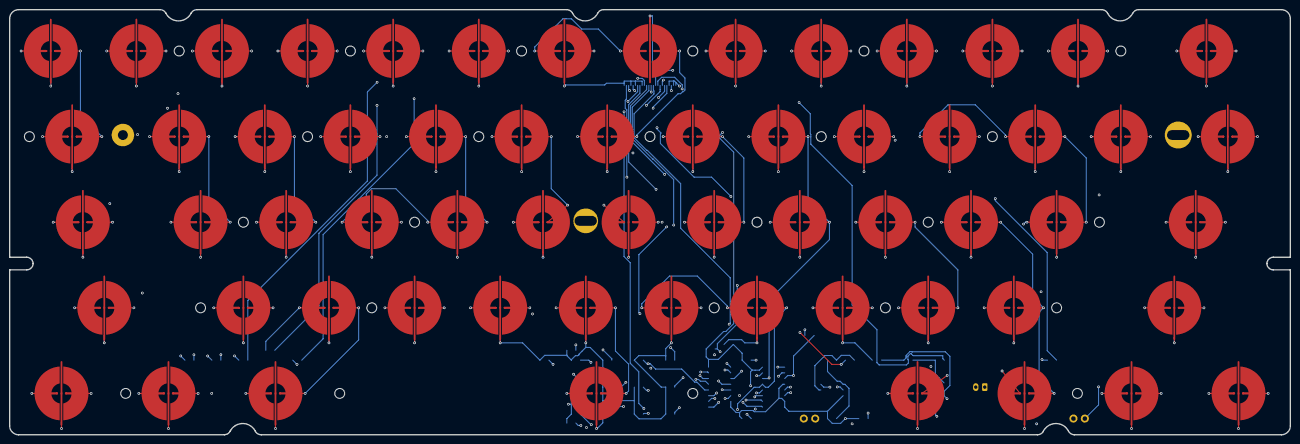
[picture p26: board UnextendedEC.kicad_pcb from above]

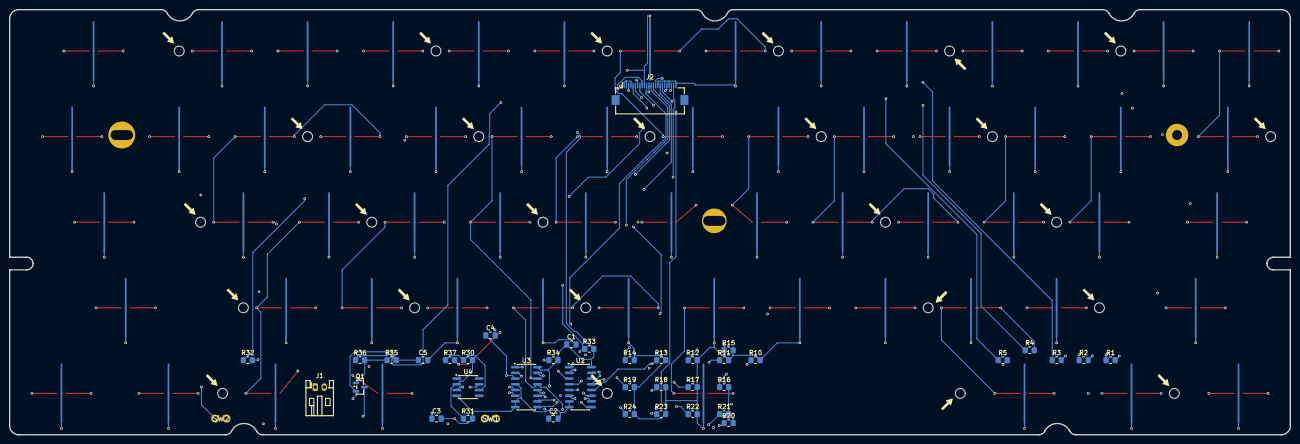
[picture p27: board UnextendedEC.kicad_pcb from below]

Board: 4 copper layers, 285.0 x 94.6 mm, 128 parts (41 on the bottom side), 43 nets.

Other parts of the board:
H1, H2, H3, H4, H5, H6, H7, H8, H9, H10, H11, H12, H13, H14, H15, H16, H17, H18, H19, H20, H21, H22, H23, H24, H25, H26: MountingHole; HOLE_M2
