wZuck/Unextended/hardware/UnextendedEC-controller.kicad_pcb

## KiCad design hardware/UnextendedEC-controller.kicad_pcb (2026-10-23)

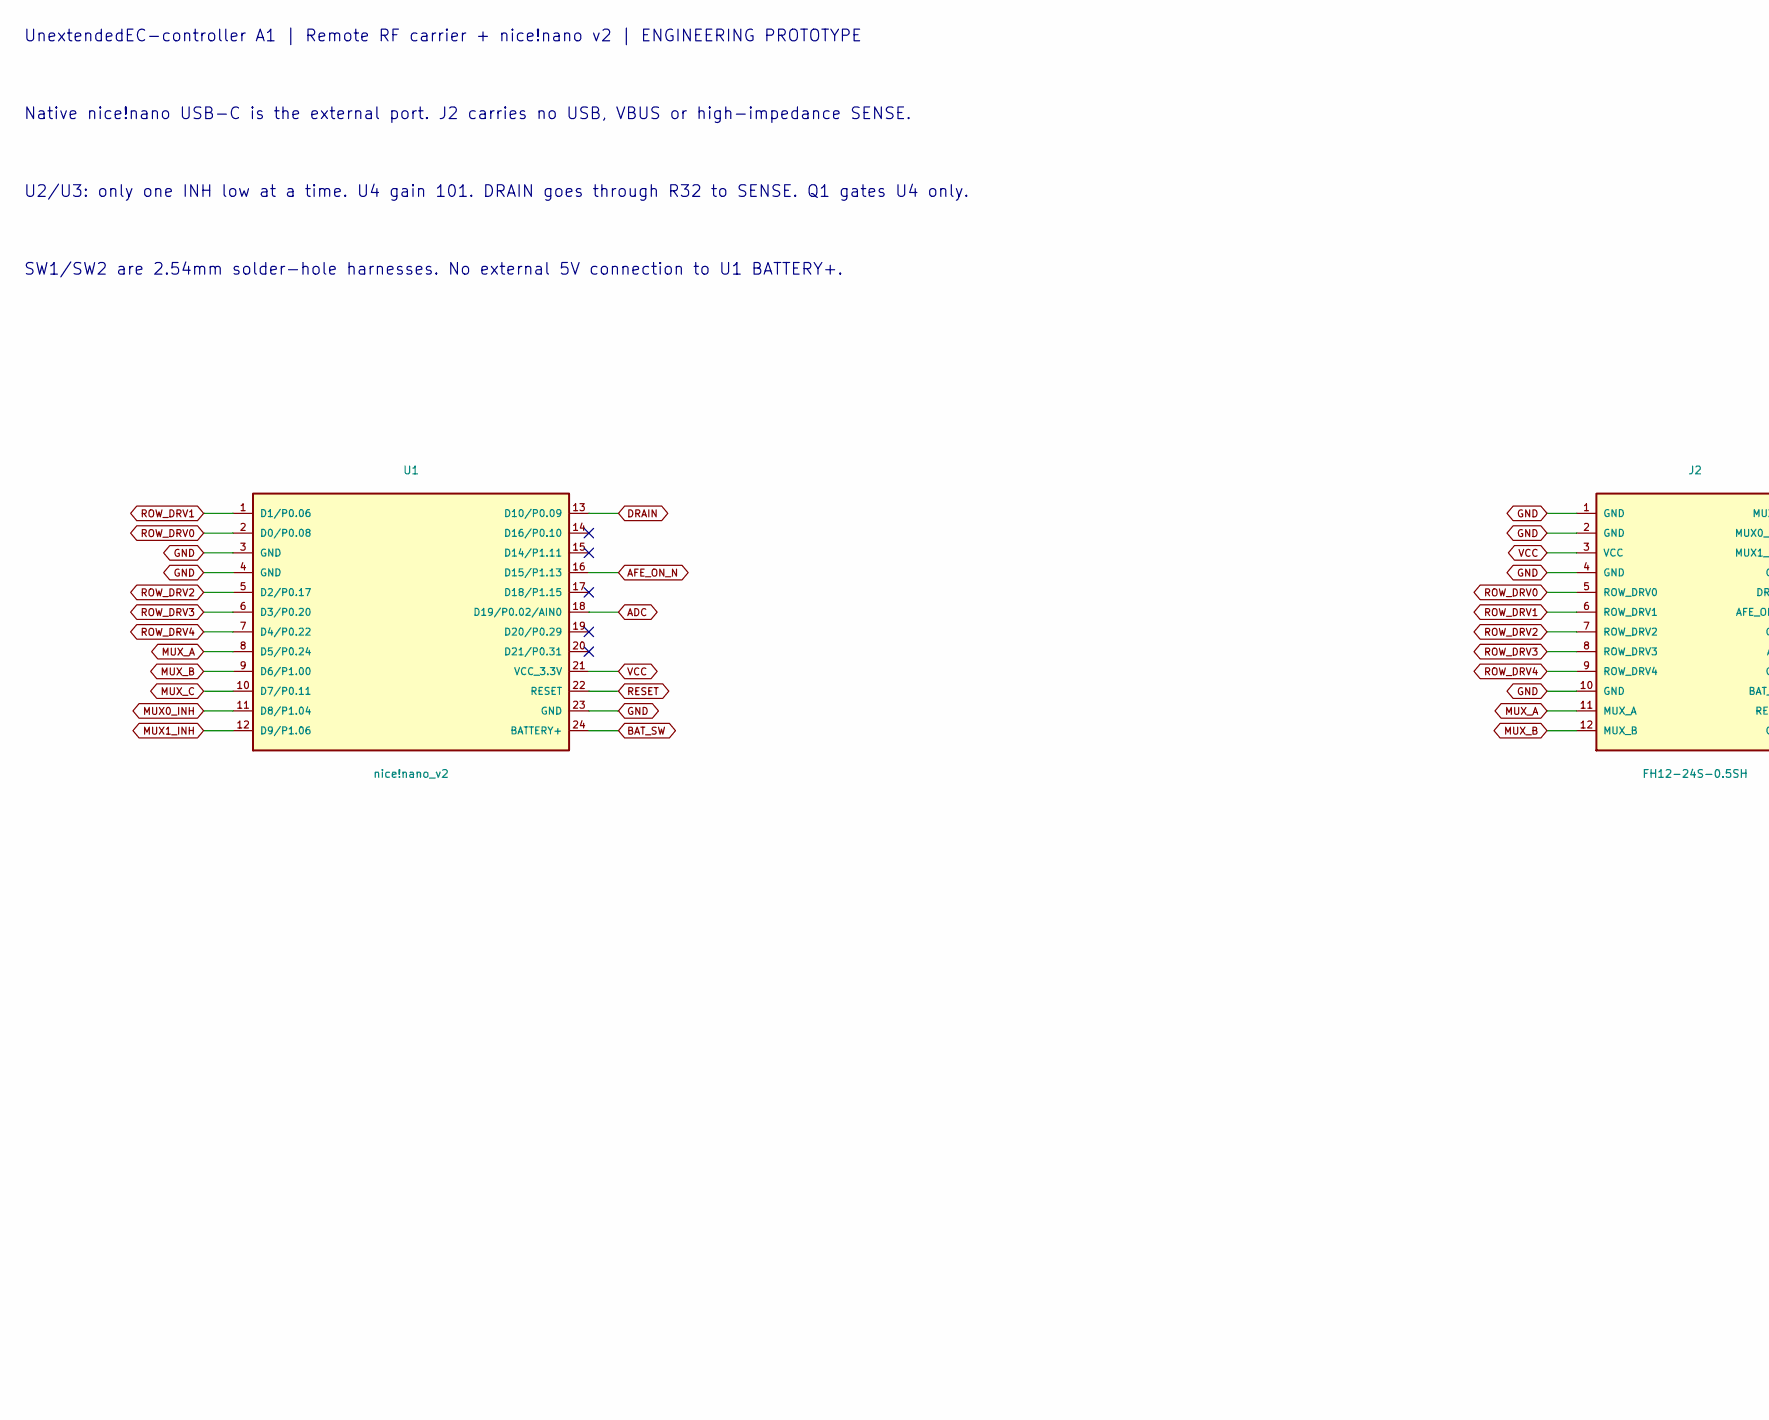
[picture p28: schematic UnextendedEC-controller.kicad_sch, UnextendedEC-controller A2 - ENGINEERING DESIGN, part in row 1, column 1]

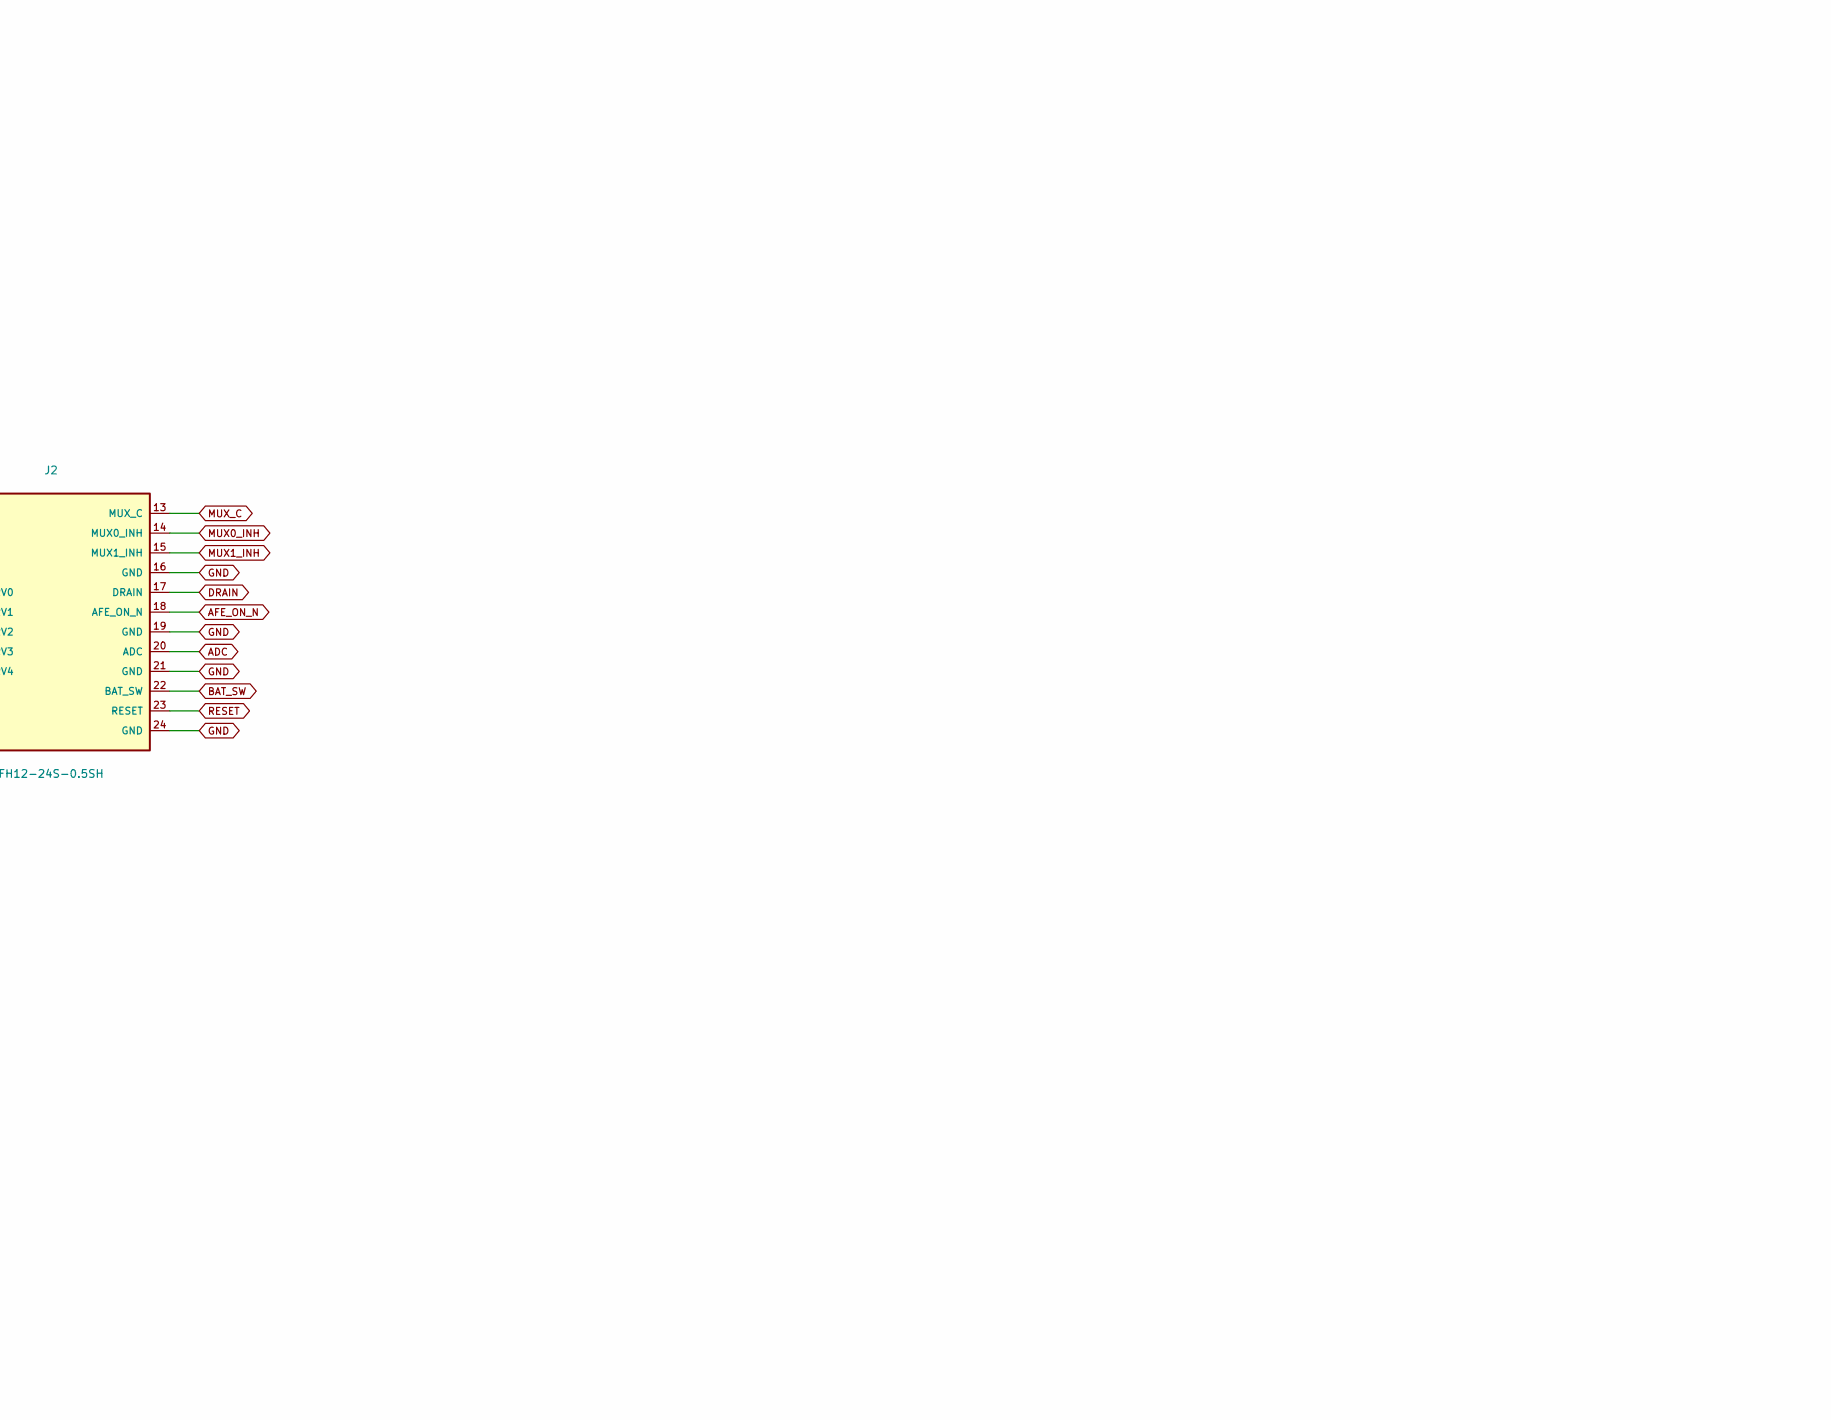
[picture p29: schematic UnextendedEC-controller.kicad_sch, UnextendedEC-controller A2 - ENGINEERING DESIGN, part in row 1, column 2]

Parts:
C6: 1n_C0G; C_0805_2012Metric_Pad1.18x1.45mm_HandSolder
J2: FH12-24S-0.5SH; Hirose_FH12-24S-0.5SH_1x24-1MP_P0.50mm_Horizontal
U1: nice!nano_v2; nice_nano

Connections:
ADC: C6.1 (ADC), J2.20 (ADC), U1.18 (D19/P0.02/AIN0)
AFE_ON_N: J2.18 (AFE_ON_N), U1.16 (D15/P1.13)
BAT_SW: J2.22 (BAT_SW), U1.24 (BATTERY+)
DRAIN: J2.17 (DRAIN), U1.13 (D10/P0.09)
GND: C6.2 (GND), J2.1 (GND), J2.2 (GND), J2.4 (GND), J2.10 (GND), J2.16 (GND), J2.19 (GND), J2.21 (GND), J2.24 (GND), U1.3 (GND), U1.4 (GND), U1.23 (GND)
MUX0_INH: J2.14 (MUX0_INH), U1.11 (D8/P1.04)
MUX1_INH: J2.15 (MUX1_INH), U1.12 (D9/P1.06)
MUX_A: J2.11 (MUX_A), U1.8 (D5/P0.24)
MUX_B: J2.12 (MUX_B), U1.9 (D6/P1.00)
MUX_C: J2.13 (MUX_C), U1.10 (D7/P0.11)
RESET: J2.23 (RESET), U1.22 (RESET)
ROW_DRV0: J2.5 (ROW_DRV0), U1.2 (D0/P0.08)
ROW_DRV1: J2.6 (ROW_DRV1), U1.1 (D1/P0.06)
ROW_DRV2: J2.7 (ROW_DRV2), U1.5 (D2/P0.17)
ROW_DRV3: J2.8 (ROW_DRV3), U1.6 (D3/P0.20)
ROW_DRV4: J2.9 (ROW_DRV4), U1.7 (D4/P0.22)
VCC: J2.3 (VCC), U1.21 (VCC_3.3V)

Notes on the sheet:
UnextendedEC-controller A1 | Remote RF carrier + nice!nano v2 | ENGINEERING PROTOTYPE
Native nice!nano USB-C is the external port. J2 carries no USB, VBUS or high-impedance SENSE.
U2/U3: only one INH low at a time. U4 gain 101. DRAIN goes through R32 to SENSE. Q1 gates U4 only.
SW1/SW2 are 2.54mm solder-hole harnesses. No external 5V connection to U1 BATTERY+.
EC electrodes: logical row = physical row; column = floor(x_u + width_u/2), including empty column bins.

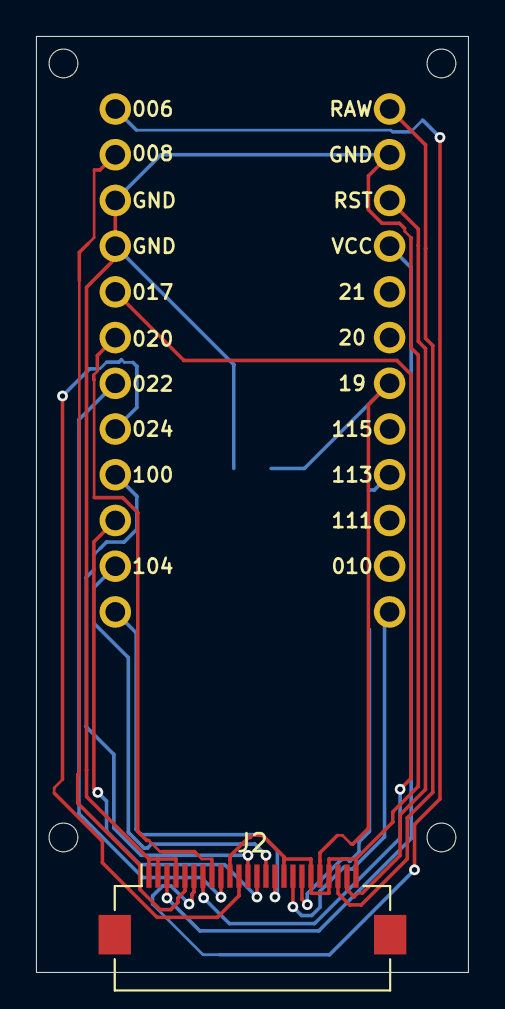
[picture p30: board UnextendedEC-controller.kicad_pcb from above]

Board: 2 copper layers, 24.0 x 52.0 mm, 7 parts (1 on the bottom side), 17 nets.

Other parts of the board:
MH1, MH2, MH3, MH4: (no value)
