wZuck/Unextended/hardware/reference/EC60.kicad_pcb

## KiCad design hardware/reference/EC60.kicad_pcb (2026-10-23)

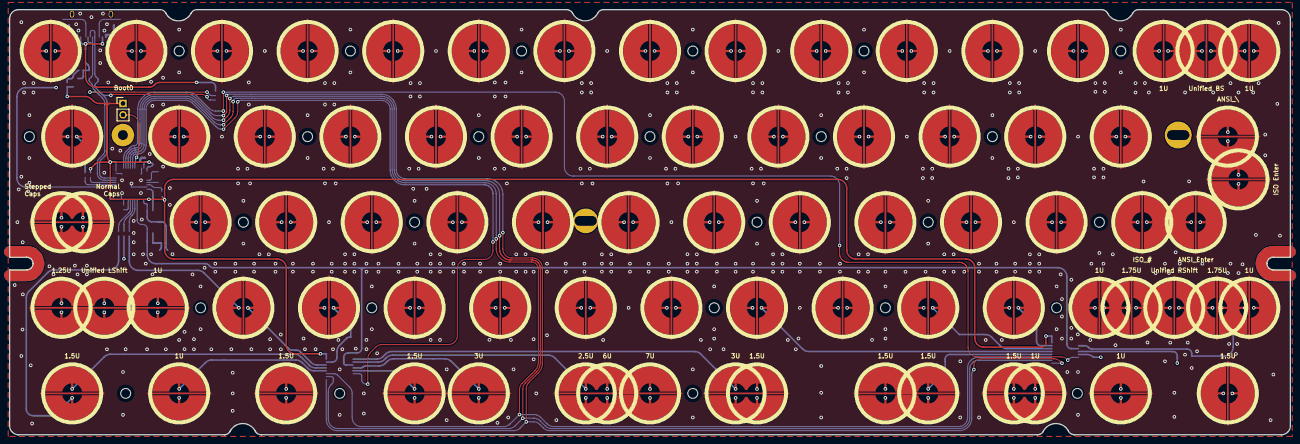
[picture p31: board EC60.kicad_pcb from above]

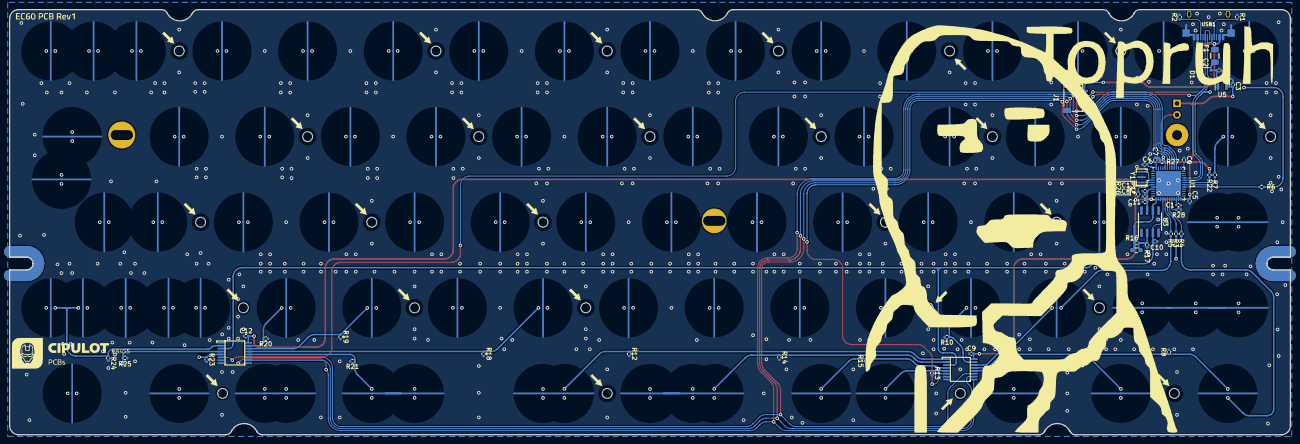
[picture p32: board EC60.kicad_pcb from below]

Board: 4 copper layers, 285.0 x 94.6 mm, 153 parts (52 on the bottom side), 48 nets.

Parts:
C1: 4.7u; C_0402_1005Metric
C2, C3, C13: 1u; C_0402_1005Metric
C4, C5, C6, C7, C8, C9, C11, C12: 100n; C_0402_1005Metric
C10: 220p; C_0402_1005Metric
D1: PRTR5V0U2X; SOT-143
F1: 500mA; Fuse_1206_3216Metric
H1, H2, H3, H4, H5, H6, H7, H8, H9, H10, H11, H12, H13, H14, H15, H16, H17, H18, H19, H20, H21, H22, H23, H24, H25, H26: MountingHole; HOLE_M2
J1: JST; JST-SR-4
JP1: Ext_Res; R_0603_1608Metric_Pad0.98x0.95mm_HandSolder
R1, R2: 5.1k; R_0402_1005Metric
R3, R4, R5, R6, R7: 100; R_0402_1005Metric
R8, R9, R10, R11, R12, R13, R14, R15, R16, R18, R19, R20, R21, R22, R23, R24, R25: 100k; R_0402_1005Metric
R17: 1k; R_0402_1005Metric
R26, R27, R28: 10k; R_0402_1005Metric
SW1: BOOT0; PinHeader_1x02_P2.54mm_Vertical
SW2, SW3, SW4, SW5, SW6, SW7, SW8, SW9, SW10, SW11, SW12, SW13, SW14, SW15, SW16, SW17, SW18, SW19, SW20, SW21, SW22, SW23, SW24, SW25, SW26, SW27, SW28, SW29, SW30, SW34, SW35, SW36, SW37, SW38, SW39, SW40, SW41, SW42, SW43, SW44, SW47, SW50, SW51, SW52, SW53, SW54, SW55, SW56, SW57, SW58, SW59, SW61, SW63, SW64, SW65, SW66, SW67, SW70, SW72, SW73, SW74, SW75: EC_SW; ecs_pad_no_ring
SW31: ANSI_\; ecs_pad_no_ring
SW32: ISO_Enter; ecs_pad_no_ring
SW33, SW68, SW69, SW71: EC_SW; ecs_pad_no_ring_stepped&normal
SW45: ISO_|; ecs_pad_no_ring
SW46: ANSI_Enter; ecs_pad_no_ring
SW48, SW49: EC_SW; ecs_pad_no_ring_1u_edge_cut
SW60, SW62: EC_SW_1u&1.75u; ecs_pad_no_ring_1u1.75u
U1: STM32F401CBUx; QFN-48-1EP_7x7mm_P0.5mm_EP5.6x5.6mm
U2, U4: 74HC4051; TSSOP16
U3: OPA350; SOIC-8_3.9x4.9mm_P1.27mm
U5: XC6206PxxxMR; SOT-23
USB1: XUNPU-TYPEC-312DSS-ACP16; XUNPU-TYPEC-312DSS-ACP16-Assembly
Y1: 8 MHz; Resonator_SMD_Murata_CSTxExxV-3Pin_3.0x1.1mm

Connections:
+5V: C2.1, D1.4 (VCC), F1.1, U5.3 (VI)
ADC: JP1.1 (A), R16.1, U1.13 (PA3), U3.6 (OUT)
AMUX_SEL_0: U1.42 (PB6), U2.11 (S0), U4.11 (S0)
AMUX_SEL_1: U1.41 (PB5), U2.10 (S1), U4.10 (S1)
AMUX_SEL_2: U1.40 (PB4), U2.9 (S2), U4.9 (S2)
APLEX_EN_PIN_0: U1.43 (PB7), U2.6 (~E)
APLEX_EN_PIN_1: U1.39 (PB3), U4.6 (~E)
APLEX_OUT_PIN_0: C10.1, U1.16 (PA6), U2.3 (A), U3.3 (IN+), U4.3 (A)
BOOT0: R27.1, SW1.2 (B), U1.44 (BOOT0)
BOOT1: R28.2, U1.20 (PB2)
COL0: R8.1, SW2.1, SW18.1, SW33.1, SW47.2, SW48.1, SW63.1, U2.13 (A0)
COL1: R11.1, SW3.1, SW19.1, SW34.1, SW49.2, SW64.1, U2.12 (A3)
COL2: R9.1, SW4.1, SW20.1, SW35.1, SW50.1, SW65.1, U2.14 (A1)
COL3: R10.1, SW5.1, SW21.1, SW36.1, SW51.1, U2.15 (A2)
COL4: R13.1, SW6.1, SW22.1, SW37.1, SW52.1, SW66.1, U2.5 (A5)
COL5: R15.1, SW7.1, SW23.1, SW38.1, SW53.1, SW67.1, U2.4 (A7)
COL6: R14.1, SW8.1, SW24.1, SW39.1, SW54.1, SW68.1, SW75.1, U2.2 (A6)
COL7: R12.1, SW9.1, SW25.1, SW40.1, SW55.1, SW69.1, U2.1 (A4)
COL8: R18.1, SW10.1, SW26.1, SW41.1, SW56.1, U4.13 (A0)
COL9: R21.1, SW11.1, SW27.1, SW42.1, SW57.1, SW70.1, SW74.1, U4.12 (A3)
COL10: R19.1, SW12.1, SW28.1, SW43.1, SW58.1, SW71.1, U4.14 (A1)
COL11: R20.1, SW13.1, SW29.1, SW44.1, SW59.1, SW72.1, U4.15 (A2)
COL12: R23.1, SW14.1, SW30.1, SW45.1, SW60.1, SW73.1, U4.5 (A5)
COL13: R25.1, SW15.1, SW31.1, SW32.2, SW46.2, SW60.3, SW61.1, U4.4 (A7)
COL14: R24.1, SW16.1, SW17.1, SW62.2, U4.2 (A6)
D+: D1.2 (I/O1), J1.3, U1.33 (PA12), USB1.6 (DP1), USB1.8 (DP2)
D-: D1.3 (I/O2), J1.2, U1.32 (PA11), USB1.5 (DN2), USB1.7 (DN1)
GND: C1.2, C2.2, C3.2, C4.2, C5.2, C6.2, C7.2, C8.2, C9.1, C10.2, C11.1, C12.1, C13.2, D1.1 (GND), J1.4, R1.1, R2.2, R8.2, R9.2, R10.2, R11.2, R12.2, R13.2, R14.2, R15.2, R17.2, R18.2, R19.2, R20.2, R21.2, R23.2, R24.2, R25.2, R27.2, R28.1, SW2.3 (SG), SW3.3 (SG), SW4.3 (SG), SW5.3 (SG), SW6.3 (SG), SW7.3 (SG), SW8.3 (SG), SW9.3 (SG), SW10.3 (SG), SW11.3 (SG), SW12.3 (SG), SW13.3 (SG), SW14.3 (SG), SW15.3 (SG), SW16.3 (SG), SW17.3 (SG), SW18.3 (SG), SW19.3 (SG), SW20.3 (SG), SW21.3 (SG), SW22.3 (SG), SW23.3 (SG), SW24.3 (SG), SW25.3 (SG), SW26.3 (SG), SW27.3 (SG), SW28.3 (SG), SW29.3 (SG), SW30.3 (SG), SW31.3 (SG), SW32.3 (SG), SW33.3 (SG), SW34.3 (SG), SW35.3 (SG), SW36.3 (SG), SW37.3 (SG), SW38.3 (SG), SW39.3 (SG), SW40.3 (SG), SW41.3 (SG), SW42.3 (SG), SW43.3 (SG), SW44.3 (SG), SW45.3 (SG), SW46.3 (SG), SW47.3 (SG), SW48.3 (SG), SW49.3 (SG), SW50.3 (SG), SW51.3 (SG), SW52.3 (SG), SW53.3 (SG), SW54.3 (SG), SW55.3 (SG), SW56.3 (SG), SW57.3 (SG), SW58.3 (SG), SW59.3 (SG), SW60.4 (SG), SW61.3 (SG), SW62.4 (SG), SW63.3 (SG), SW64.3 (SG), SW65.3 (SG), SW66.3 (SG), SW67.3 (SG), SW68.3 (SG), SW69.3 (SG), SW70.3 (SG), SW71.3 (SG), SW72.3 (SG), SW73.3 (SG), SW74.3 (SG), SW75.3 (SG), U1.8 (VSSA), U1.23 (VSS), U1.35 (VSS), U1.47 (VSS), U1.49 (VSS), U2.7 (VEE), U2.8 (GND), U3.4 (V-), U4.1 (A4), U4.7 (VEE), U4.8 (GND), U5.1 (GND), USB1.1 (GND), USB1.12 (GND), USB1.13 (SHIELD), Y1.2
NRST: R26.2, U1.7 (NRST)
unnamed: C1.1, U1.22 (VCAP1)
unnamed: JP1.2 (B), R16.2, R17.1, U3.2 (IN-)
unnamed: R1.2, USB1.4 (CC1)
unnamed: R2.1, USB1.10 (CC2)
unnamed: R3.1, U1.18 (PB0)
unnamed: R4.2, U1.19 (PB1)
unnamed: R5.1, U1.17 (PA7)
unnamed: R6.2, U1.29 (PA8)
unnamed: R7.1, U1.30 (PA9)
unnamed: R22.1, U1.31 (PA10)
ROW0: R6.1, SW2.2, SW3.2, SW4.2, SW5.2, SW6.2, SW7.2, SW8.2, SW9.2, SW10.2, SW11.2, SW12.2, SW13.2, SW14.2, SW15.2, SW16.2, SW17.2
ROW1: R7.2, SW18.2, SW19.2, SW20.2, SW21.2, SW22.2, SW23.2, SW24.2, SW25.2, SW26.2, SW27.2, SW28.2, SW29.2, SW30.2, SW31.2, SW32.1
ROW2: R3.2, SW33.2, SW34.2, SW35.2, SW36.2, SW37.2, SW38.2, SW39.2, SW40.2, SW41.2, SW42.2, SW43.2, SW44.2, SW45.2, SW46.1
ROW3: R5.2, SW47.1, SW48.2, SW49.1, SW50.2, SW51.2, SW52.2, SW53.2, SW54.2, SW55.2, SW56.2, SW57.2, SW58.2, SW59.2, SW60.2, SW62.3
ROW4: R4.1, SW61.2, SW62.1, SW63.2, SW64.2, SW65.2, SW66.2, SW67.2, SW68.2, SW69.2, SW70.2, SW71.2, SW72.2, SW73.2, SW74.2, SW75.2
VBAT: C3.1, C4.1, C5.1, C6.1, C7.1, C8.1, C9.2, C11.2, C12.2, C13.1, R22.2, R26.1, SW1.1 (A), U1.1 (VBAT), U1.9 (VREF+), U1.24 (VDD), U1.36 (VDD), U1.48 (VDD), U2.16 (VCC), U3.7 (V+), U4.16 (VCC), U5.2 (VO)
VBUS: F1.2, J1.1, USB1.2 (VBUS), USB1.11 (VBUS)
XTAL0: U1.5 (PH0), Y1.3
XTAL1: U1.6 (PH1), Y1.1
